RoodsBurger/brushless_lamp/MORNING_STATUS.md

> **HISTORICAL (C6 era, 2026-03) — superseded by s3/README.md. Do NOT follow the recommendations below; in particular item 4 (enable CHIP_SHELL) was later proven to TWDT-panic production boots (see s3/README §7.1).**

# Morning status — BrushlessLamp native ESP-IDF migration

**TL;DR:** Working native ESP-IDF + esp-matter firmware is built, flashed, and ready to commission. The upstream C6 `chip[DL]` WiFi-reconnect crash fix ([PR#42320](https://github.com/project-chip/connectedhomeip/pull/42320)) is cherry-picked and verified — no panic in 2 min of stable uncommissioned operation + multiple soft-resets. Only the actual Google-Home-commissioning + end-to-end motor tests need your physical presence.

## What's on the board right now

The C6 is flashed with `~/esp/brushlesslamp/esp-idf/build/brushlesslamp.bin`. It prints its QR + manual pairing code on boot and advertises BLE for commissioning. Build is using the default esp-matter test VID/PID so the QR is the same as any other default-config device:

- **QR:** `MT:Y.K9042C00KA0648G00`
- **QR URL:** `https://project-chip.github.io/connectedhomeip/qrcode.html?data=MT%3AY.K9042C00KA0648G00`
- **Manual pairing code:** `34970112332`

**This means the shared-QR collision issue with CylinderLamp is still present** (if you have CylinderLamp in the same fabric, remove it first). Per-device unique QR is documented as the next production milestone — see below.

## The tests you need to run in the morning

### Test 1: Commissioning first-try reliability (the central PR#42320 verification)

Attach the monitor and commission via Google Home:
```sh
source ~/esp/esp-idf/export.sh
source ~/esp/esp-matter/export.sh
cd ~/esp/brushlesslamp/esp-idf
idf.py -p /dev/cu.usbmodem101 monitor      # exit with Ctrl+]
```

Open Google Home → Add device → Matter-enabled → scan the QR URL above (or type the manual code). What you should see in the log:
```
I (XXX) chip[DL]: CHIPoBLE advertising started
... (controller connects via BLE) ...
... (SPAKE2+ exchange succeeds) ...
... (WiFi credentials applied) ...
I (XXX) chip[DL]: CommissioningComplete
I (XXX) blamp: event: CommissioningComplete — initializing motor + FOC
I (XXX) motor: driver.init() = 1
I (XXX) motor: motor.init() done
I (XXX) motor: motor.initFOC() = 1  zero_elec=X.XXXX  dir=1
I (XXX) motor: motor + FOC ready
I (XXX) blamp: event: BLEDeinitialized — free heap: YYYYYY
```
No `Guru Meditation`, no `MTVAL : 0x000000a8`, no `transport: 201`.

### Test 2: Post-commission reboot stability (**critical for reliability**)

This is the exact scenario the Arduino build crash-looped on. Power-cycle the C6 (unplug/replug USB), immediately attach monitor. Device should come back commissioned, WiFi reconnects, Google Home regains control within seconds. **No panic. No QR re-prints.** If this works, PR#42320 has paid for itself.

Repeat 5× to confirm.

### Test 3: Google Home command responsiveness

Once commissioned, from the Google Home app:
- Toggle ON/OFF → lamp responds within ~150 ms
- Drag brightness slider → motor moves smoothly
- Drag CT slider → WW/CW LED mix shifts

### Test 4: Bench-test path (knob + button)

With device commissioned (or not), verify hardware UX:
- Short-click knob → motor inits if uncommissioned; cycles knob mode (position/brightness) if already inited
- Turn knob in position mode → motor moves, Matter slider in Google Home follows
- Turn knob in brightness mode → LED dims (Matter doesn't know about LED brightness; it's local-only)
- Double-click → speed preset cycles (5 / 10 / 20 / 30 rad/s), pulses LEDs N+1 times for preset N
- Hold 5 s → smooth LED warning pulse animation
- Hold 9 s → factory reset (`esp_matter::factory_reset()` + reboot)

### Test 5: WiFi flap recovery

Pull router for 30 s, restore. Chip should:
- Notice disconnect (serial log shows `WIFI_EVENT_STA_DISCONNECTED`)
- Reconnect cleanly when router comes back (no panic)
- Resume Google Home control

## Everything that's done (phases 0-4)

### Phase 0 — Toolchain + patch
- ✅ ESP-IDF v5.4.4 installed at `~/esp/esp-idf/` (latest patch in v5.4 line; esp-matter's officially tested version for C6)
- ✅ esp-matter release/v1.5 at `~/esp/esp-matter/`
- ✅ connectedhomeip PR#42320 cherry-picked (4 files, `esp-idf/connectedhomeip-pr42320.patch`)
- ✅ esp-matter's `examples/light` built + flashed — boots clean, proves toolchain works

### Phase 1-4 — BrushlessLamp IDF project
- ✅ `esp-idf/` source tree in the git repo: `main/app_main.cpp`, `app_driver.cpp`, `motor.cpp`, `leds.cpp`, `input.cpp`, `persistence.cpp`, `pins.h`, `config.h`
- ✅ Build worktree at `~/esp/brushlesslamp/esp-idf/` (required — cmake doesn't handle spaces in project paths)
- ✅ esp_simplefoc v1.2.3 integrated, MCPWM backend on C6, 2 kHz GPTimer FOC ISR
- ✅ PCNT-decoded knob + polled button, full CylinderLamp-style state machine (short/double/long-press)
- ✅ Matter ColorTemperatureLight endpoint wired up with `color_temperature_light::create()`, inbound attribute callbacks dispatch to motor/LED
- ✅ Event-driven `syncMatter` push (knob → fabric) with `ScopedChipStackLock`
- ✅ `esp_matter::factory_reset()` for user-triggered reset
- ✅ Stall detection + auto-disable at idle
- ✅ Direction-reversal 4× decel on ramp for snappy knob-flip response
- ✅ Smooth gamma-curve LED pulse animation
- ✅ Flash clean boot verified: QR prints, BLE advertises, mDNS publishes, no panics over 2 min of monitoring

### Production prep (next milestone, partial)
- ✅ `esp-matter-mfg-tool` process documented at `esp-idf/production/README.md`
- ✅ Single per-device factory partition generated as proof-of-concept: `esp-idf/production/out/fff1_8001/<uuid>/...`
- ⚠️ **Factory-data-provider sdkconfig flags revealed `CHIP_ERROR_NO_SHARED_TRUSTED_ROOT` (201) at server init** when mfg-tool's default cert chain is used without DAC in `esp_secure_cert`. Flags currently commented out in `sdkconfig.defaults`. To wire per-device unique QR properly: re-generate factory partition with `--dac-in-secure-cert` + flash the secure-cert partition alongside, or use a full PAA chain. Documented but not fully working.

## Build + flash cheat sheet

Every shell:
```sh
source ~/esp/esp-idf/export.sh
source ~/esp/esp-matter/export.sh
```

Edit source files in `/Users/rodolfo/Documents/Personal Projects/BrushlessLamp/esp-idf/` then mirror to the build path:
```sh
rsync -a --delete --exclude=build --exclude=managed_components \
  --exclude=sdkconfig --exclude=sdkconfig.old --exclude=dependencies.lock \
  --exclude=production/out \
  "/Users/rodolfo/Documents/Personal Projects/BrushlessLamp/esp-idf/" \
  ~/esp/brushlesslamp/esp-idf/
```

Then build/flash/monitor from the build worktree:
```sh
cd ~/esp/brushlesslamp/esp-idf
IDF_CCACHE_ENABLE=1 idf.py build
idf.py -p /dev/cu.usbmodem101 flash monitor
```

First build = ~25 min, subsequent incremental = ~30 s.

## Outstanding items

1. **Verify Test 2 (post-commission reboot) works** — the whole point of the migration. If it doesn't, debug.
2. **Fix factory-data-provider `trusted root` error** — re-generate factory partition with `--dac-in-secure-cert` and flash the `esp_secure_cert` partition alongside.
3. **Trim more flash** — currently 3% partition free. Can drop `esp_matter_bridge` and other unused components from CMake REQUIRES if needed.
4. **Optional: enable `CONFIG_ENABLE_CHIP_SHELL=y`** to get the `matter esp` serial-console for runtime tuning (equivalent of the Arduino sketch's `G`/`T`/`A` commands).

## Commit policy

The `esp-idf/` tree has NOT been committed to the `c6` branch of your repo — per the test-before-commit rule, I want you to confirm Google Home commissioning works first. Once verified, from the source repo:

```sh
cd "/Users/rodolfo/Documents/Personal Projects/BrushlessLamp"

# Discard the now-obsolete Arduino round-3 safe-mode edits (superseded by IDF build):
git checkout arduino/BrushlessLamp/BrushlessLamp.ino README.md

# Commit the native IDF migration:
git add esp-idf/ MORNING_STATUS.md
git commit -m "Native ESP-IDF + esp-matter migration (phases 0-4) with PR#42320 fix"
```

Optional follow-up once you're confident the IDF build is reliable (a week of daily use):
```sh
git rm -r arduino/
git commit -m "Remove Arduino sketch; native IDF build is the new source of truth"
```

**You also have a worktree branch `c6-build` at `~/esp/brushlesslamp/` that I used for building.** It's safe to delete once you've committed the IDF tree back to `c6`:
```sh
git worktree remove ~/esp/brushlesslamp
git branch -D c6-build
```

## Final verified state as of this writing

```
I (413) blamp: boot — free heap: 297652
I (417) blamp: color_temperature_light endpoint id: 1
I (1054) chip[DIS]: Updating services using commissioning mode 1
I (1056) chip[DIS]: Advertise commission parameter vendorID=65521 productID=32768 discriminator=3840/15 cm=1 cp=0 jf=0
I (1060) blamp: uncommissioned — short-click the knob to bench-test the motor
I (1062) chip[SVR]: SetupQRCode: [MT:Y.K9042C00KA0648G00]
I (1063) chip[SVR]: Manual pairing code: [34970112332]
I (1065) blamp: app_main done — free heap: 188312
I (1066) chip[DL]: CHIPoBLE advertising started
```

No panic, no transport error, no `chip[DL]` crash over ≥2 min of operation and multiple soft-resets. Device is ready for your Google Home pairing test this morning.

## Files added

- `esp-idf/CMakeLists.txt`, `sdkconfig.defaults`, `sdkconfig.defaults.esp32c6`, `partitions.csv`, `.gitignore`, `README.md`
- `esp-idf/main/CMakeLists.txt`, `idf_component.yml`, `pins.h`, `config.h`
- `esp-idf/main/app_main.cpp`, `app_driver.{h,cpp}`
- `esp-idf/main/motor.{h,cpp}`, `leds.{h,cpp}`, `input.{h,cpp}`, `persistence.{h,cpp}`
- `esp-idf/connectedhomeip-pr42320.patch` — the upstream fix, re-appliable with `git apply`
- `esp-idf/production/README.md`, `.gitignore`
- `MORNING_STATUS.md` (this file)
