RoodsBurger/brushless_lamp/PCB/PCBWay-BOM.xlsx

Sheet: BOM
Item # | *Designator | *Qty | Manufacturer | *Mfg Part # | Description / Value | *Package/Footprint | Type | LCSC# | Your Instructions / Notes
1 | U_MCU | 1 | Espressif | ESP32-S3-WROOM-1-N8R8 | ESP32-S3-WROOM-1-N8R8 | Module | SMD | C2913201 | WiFi/BLE MCU module 8MB+8MB; 8MB N8R8 (C2913202 is the N16R8); LCSC verified
2 | U_DRV | 1 | Texas Instruments | DRV8313PWPR | DRV8313PWPR | HTSSOP-28 | SMD | C92482 | 3-phase BLDC gate driver; thermal pad to GND
3 | U_BUCK | 1 | Texas Instruments | LMR51430YDDCR | LMR51430YDDCR | SOT-23-6 | SMD | C5210749 | 24V->3.3V 3A buck
4 | D_USB | 1 | STMicroelectronics | USBLC6-2SC6 | USBLC6-2SC6 | SOT-23-6 | SMD | C7519 | USB ESD protection array
5 | Q_WW;Q_CW | 2 | Alpha & Omega | AO3400A | AO3400A | SOT-23 | SMD | C20917 | N-MOSFET LED low-side
6 | Q1 | 1 | Alpha & Omega | AO3401A | AO3401A | SOT-23 | SMD | C15127 | P-MOSFET reverse-protect
7 | D_OR_USB | 1 | MDD/Diodes | SS14 | SS14 | SMA | SMD | C2480 | Schottky 40V 1A; VBUS diode-OR to buck input
8 | D_Q1 | 1 | Shikues | BZT52C10 | BZT52C10 | SOD-123 | SMD | C216719 | Zener 10V 0.5W; Q1 gate-to-source clamp (AO3401A Vgs abs-max +/-12V)
9 | TVS1 | 1 | Littelfuse | SMBJ28A | SMBJ28A | SMB | SMD | C178227 | TVS 28V unidirectional 600W; 24V clamp - small/typical surges below buck 38V abs-max; full-surge VC 45.4V exceeds it (accepted residual risk)
10 | D_MCU | 1 | Bourns | CDSOD323-T03SC | ESD 3.3V | SOD-323 | SMD | C840638 | TVS/ESD 3.3V working; generic 3V3 ESD; optional - may DNP
11 | D_CLW;D_CLC | 2 | - | - | clamp | SOD-323 | DNS | - | LED drain TVS/Schottky; DNP - populate only if drain ringing >30V
12 | R_AZ_A;R_AZ_B;R_AZ_C | 3 | UNI-ROYAL | 0603WAF1002T5E | 10k | 0603 | DNS | C25804 | encoder A/B/Z pull-up stiffening to 3V3; DNP - populate only for a long/noisy encoder cable
13 | LED_STATUS | 1 | Everlight | 19-217/GHC-YR1S2/3T | Green LED | 0603 | SMD | C72043 | status indicator; generic green 0603; optional
14 | R_EN;R_BOOT;R_NSLEEP;R_NRESET;R_NFAULT;R_EN_DRV;R_FBB | 7 | UNI-ROYAL | 0603WAF1002T5E | 10k | 0603 | SMD | C25804 | thick-film 1%; pull-ups + buck FB bottom
15 | R_FBT | 1 | UNI-ROYAL | 0603WAF4532T5E | 45.3k | 0603 | SMD | C23058 | thick-film 1%; CRITICAL 1% - sets Vout=3.318V
16 | R_CC1;R_CC2 | 2 | UNI-ROYAL | 0603WAF5101T5E | 5.1k | 0603 | SMD | C23186 | USB-C CC pulldown 1%
17 | R_DP;R_DM | 2 | UNI-ROYAL | 0603WAF220JT5E | 22R | 0603 | SMD | C25092 | USB series
18 | R_Q1;R_ENB;R_PDW;R_PDC | 4 | UNI-ROYAL | 0603WAF1003T5E | 100k | 0603 | SMD | C25803 | thick-film; gate pulldowns + buck EN
19 | R_GW;R_GC | 2 | UNI-ROYAL | 0603WAF330JT5E | 33R | 0603 | SMD | C23140 | LED gate series; 33R 1%
20 | R_STATUS | 1 | UNI-ROYAL | 0603WAF1001T5E | 1k | 0603 | SMD | C21190 | LED series
21 | C_MCU3;C_MCU4;C_BOOT_B;C_SENS | 4 | Samsung | CL05B104KO5NNNC | 100nF | 0402 | SMD | C1525 | X7R 16V; decoupling
22 | C_BOOT | 1 | Samsung | CL05C101JB5NNNC | 100pF | 0402 | SMD | C26409 | C0G 50V; GPIO0 debounce - MUST stay small (never ~0.1uF); check stock
23 | C_FF | 1 | Samsung | CL05C220JB5NNNC | 22pF | 0402 | SMD | C70464 | C0G 50V; buck feed-forward (optional)
24 | C_MCU2;C_EN | 2 | Samsung | CL10B105KB8NNNC | 1uF | 0603 | SMD | C15849 | X7R 16V
25 | C_VBUS | 1 | Samsung | CL10A475KO8NNNC | 4.7uF | 0603 | SMD | C19666 | X5R 16V; VBUS bulk
26 | C_CP | 1 | Samsung | CL10B103KB8NNNC | 10nF | 0603 | SMD | C1589 | 50V X7R; charge-pump flying cap (VM-rated)
27 | C_VCP;C_VM1;C_VM2 | 3 | Samsung | CL10B104KB8NNNC | 100nF | 0603 | SMD | C1591 | 50V X7R; VCP + VM decoupling
28 | C_V3P3 | 1 | Samsung | CL10B474KO8NNNC | 470nF | 0603 | SMD | C105526 | 16V X7R; DRV V3P3 bypass (X7R; was X5R MPN not cataloged)
29 | C_MCU1 | 1 | Samsung | CL21A106KAYNNNE | 10uF | 0805 | SMD | C15850 | X5R 16V
30 | C_OUT1;C_OUT2 | 2 | Samsung | CL21A226KOQNNNE | 22uF | 0805 | SMD | C45783 | X5R 10V; buck output
31 | C_IN1 | 1 | Samsung | CL32B106KBJNNNE | 10uF | 1210 | SMD | C46653 | 50V X7R; buck input (derated 50V)
32 | C_IN2 | 1 | Samsung | CL31B475KBHNNNE | 4.7uF | 1206 | SMD | C51205 | 50V X7R; buck input (BH=50V; CH MPN was a typo)
33 | C_MCU_BULK | 1 | Kemet | T520D477M006ATE025 | 470uF 6.3V | 7343 (D) | SMD | C156460 | polymer/tantalum-polymer; *confirm CAP_D land; cures TX brownout; LCSC stock thin-buy ahead or alt T520D477M006ATE030
34 | C_IN_BULK;C_VM_BULK | 2 | Panasonic | EEE-FK1H101P | 100uF 50V | 8x10.5mm | SMD | C178548 | aluminium electrolytic SMD; *confirm CAP_V land (D8x10.2mm can)
35 | L1 | 1 | Sunlord | SWPA4030S4R7MT | 4.7uH | 4x4mm | SMD | C57269 | shielded power inductor >=1.5A; *confirm IND43 land; Wurth 74438335047 alt is 3x3mm (not land-compatible)
36 | SW_RST;SW_BOOT | 2 | XKB/various | TS-1187A-B-A-B | tactile | SMD | SMD | C318884 | SMD pushbutton 4-pad; XKB TS-1187A-B-A-B land pattern, datasheet-verified; internal contacts bridge pads pairwise per side
37 | F1 | 1 | Littelfuse | 0454002.MR | 2A | NANO2 6.1x2.7mm | SMD | C179005 | slow-blow NANO2 fuse; slo-blo; 125V rating satisfies >=63VDC need; verify FUSE_NANO2 land before fab
38 | J_USB | 1 | HRO | TYPE-C-31-M-12 | USB-C 16P | SMT | SMD | C165948 | USB-C receptacle; shell legs require PLATED SLOTS: 4x 0.6x1.7mm. Drill file represents each slot as overlapping 0.6mm drills - cut as slots per the Milling layer, do NOT drill as round holes (previous order T-1P9W1088173A failed on this).
39 | J_BTN | 1 | JST | B2B-XH-A | JST-XH 2P | THT 2.5mm | THT | C144395 | header (mate XHP-2); button SW/GND
40 | J_KNOB;J_LED | 2 | JST | B3B-XH-A | JST-XH 3P | THT 2.5mm | THT | C158012 | header (mate XHP-3); knob A/B/GND and LED V+/W/C
41 | J_PWR | 1 | Cixi Kefa | KF301-5.0-2P | Screw 2P 5.0mm | THT | THT | C474881 | terminal block; 24V V+/V-
42 | J_MOTOR | 1 | Cixi Kefa | KF301-5.0-3P | Screw 3P 5.0mm | THT | THT | C474882 | terminal block; motor U/V/W
43 | J_SENSOR-A | 1 | Cixi Kefa | KF350-3.5-3P | Screw 3P 3.5mm | THT | THT | C474893 | terminal block; encoder VCC/GND/A - 3P half; gangs with J_SENSOR-B onto the 5-pos 3.5mm SCREW5 footprint (no 5P block stocked on LCSC). Both BOM lines mount at CPL designator J_SENSOR.
44 | J_SENSOR-B | 1 | Cixi Kefa | KF350-3.5-2P | Screw 2P 3.5mm | THT | THT | C474892 | terminal block; encoder B/Z - 2P half; butts against J_SENSOR-A to fill the 5-pos block. Mounts at CPL designator J_SENSOR (see J_SENSOR-A).
45 | J_EXP | 1 | BOOMELE | 2.54-1*10P | GPIO header 1x10 | THT 2.54mm | THT | C57369 | 2.54mm male pin header; spare IO1/IO2/IO13/IO38-42 + 3V3/GND; DNP if you prefer bare pads
46 | J_PROG | 1 | - | - | prog pads | SMD pads | DNS | - | UART fallback pad field; DNP - bare test pads

Sheet: Order Notes
PCBWay order remarks (paste into the order notes field):
1 | USB-C (J_USB) shell legs are PLATED SLOTS: 4x 0.6x1.7mm. The drill file shows them as overlapping 0.6mm drills; follow the slots / Milling layer, do not drill round holes.
2 | BOM lines J_SENSOR-A (KF350-3.5-3P) and J_SENSOR-B (KF350-3.5-2P) are gangable halves that together populate the single 5-position footprint at CPL designator J_SENSOR.
3 | DNS lines (D_CLW, D_CLC, R_AZ_A/B/C, J_PROG) are do-not-populate.
4 | Board is 55x55mm, 4-layer; inner planes L2=GND, L15=3V3.
