RoodsBurger/brushless_lamp/PCB/components/KF350-2p.step

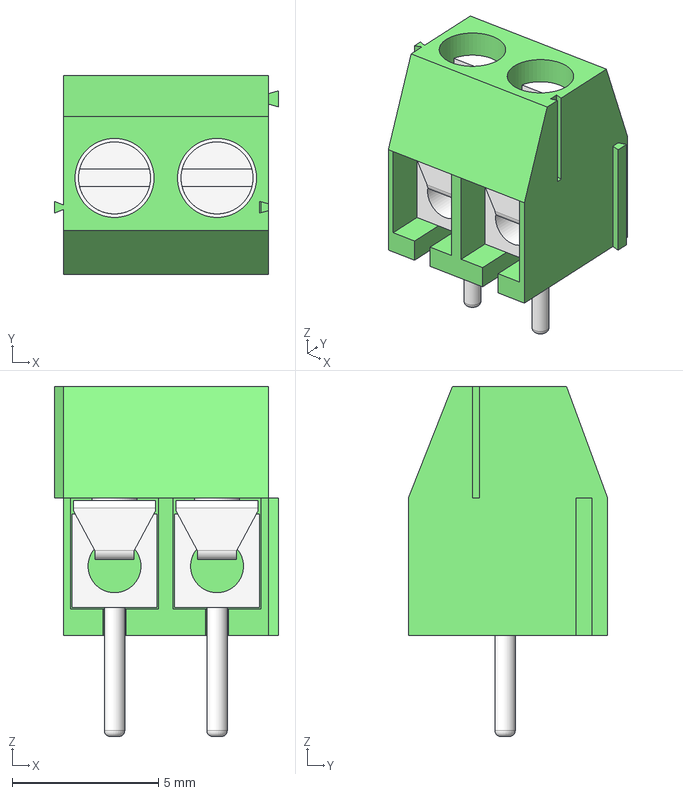
[picture p1: CAD file, 2026-07-13]
PCB/components/KF350-2p.step
7.65 x 6.80 x 11.9 mm
Corps
Conn_1
Conn_2
blade_1
blade_2
Vis_1
Vis_001
