RoodsBurger/brushless_lamp/PCB/components/TYPE-C-31-M-12--3DModel-STEP-56544.STEP

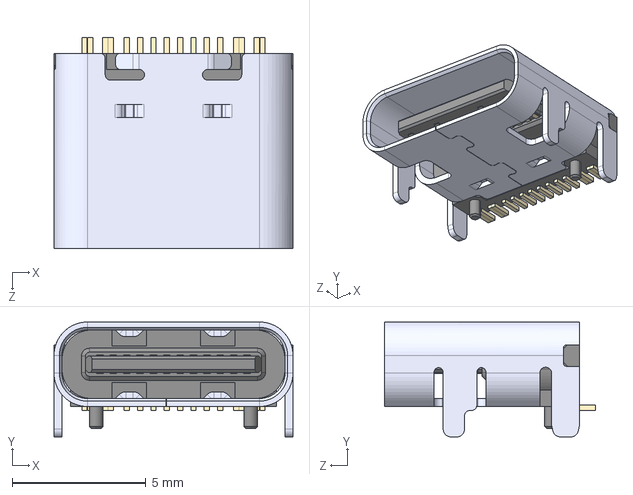
[picture p2: CAD file, 2026-07-13]
PCB/components/TYPE-C-31-M-12--3DModel-STEP-56544.STEP
8.94 x 4.30 x 7.90 mm
