RoodsBurger/brushless_lamp/PCB/components/TS-1187A-B-A-B--3DModel-STEP-56544.STEP

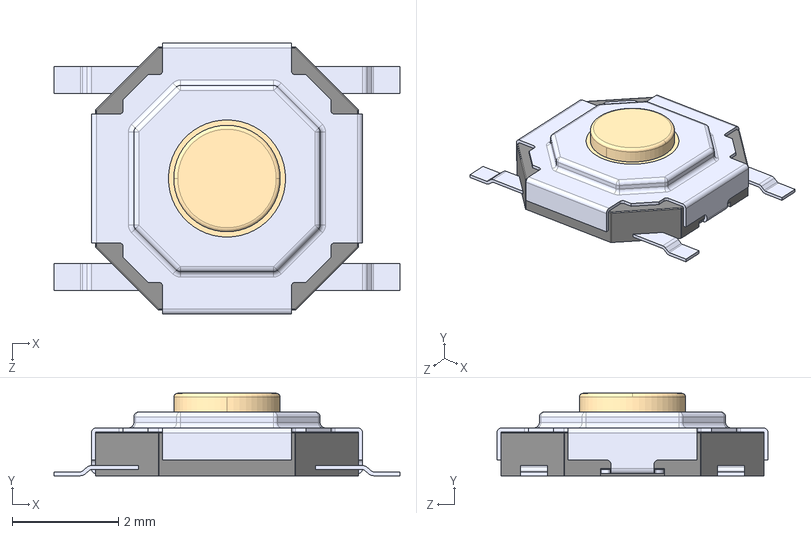
[picture p3: CAD file, 2026-07-13]
PCB/components/TS-1187A-B-A-B--3DModel-STEP-56544.STEP
6.50 x 1.55 x 5.10 mm
