RoodsBurger/brushless_lamp/PCB/components/KF350-3p.step

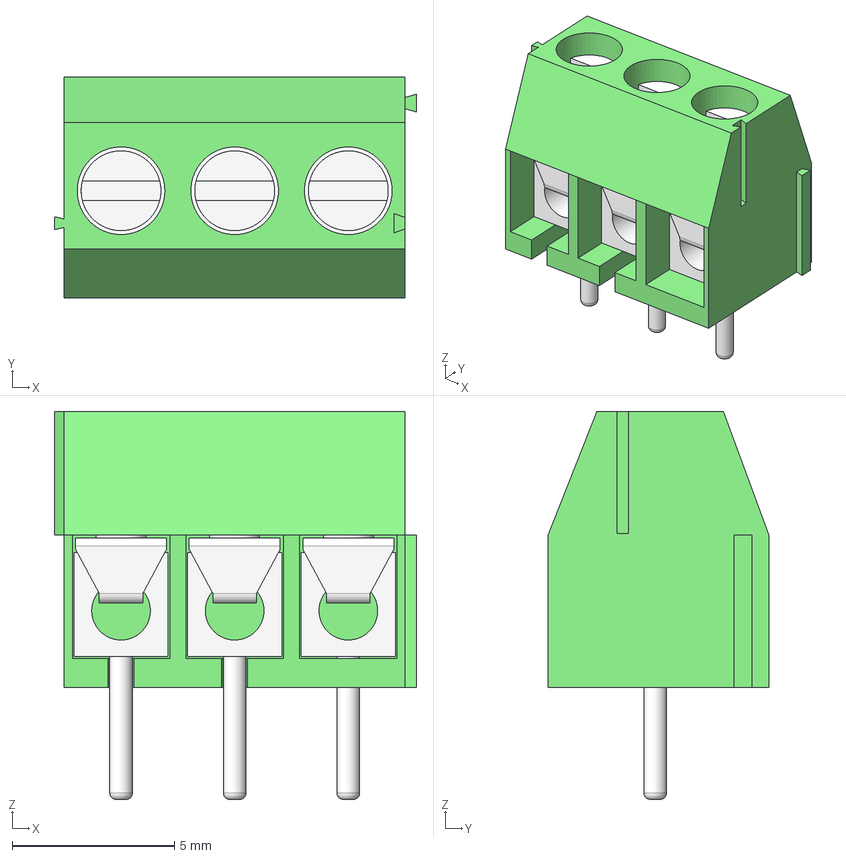
[picture p4: CAD file, 2026-07-13]
PCB/components/KF350-3p.step
11.2 x 6.80 x 11.9 mm
Corps
Conn_1 x 2
Conn_2
blade_1
blade_2 x 2
Vis_1 x 3
