RoodsBurger/brushless_lamp/PCB/components/B2B-XH-A--3DModel-STEP-56544.STEP

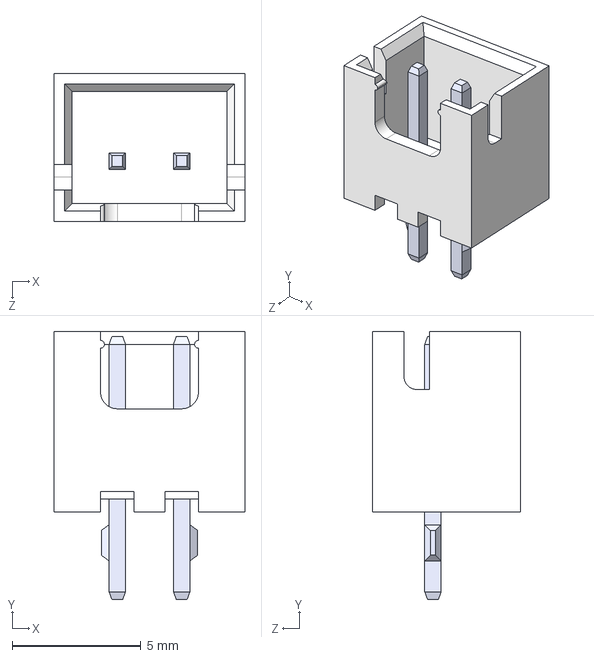
[picture p5: CAD file, 2026-07-13]
PCB/components/B2B-XH-A--3DModel-STEP-56544.STEP
7.40 x 10.4 x 5.75 mm
