RoodsBurger/brushless_lamp/PCB/components/B3B-XH-A--3DModel-STEP-56544.STEP

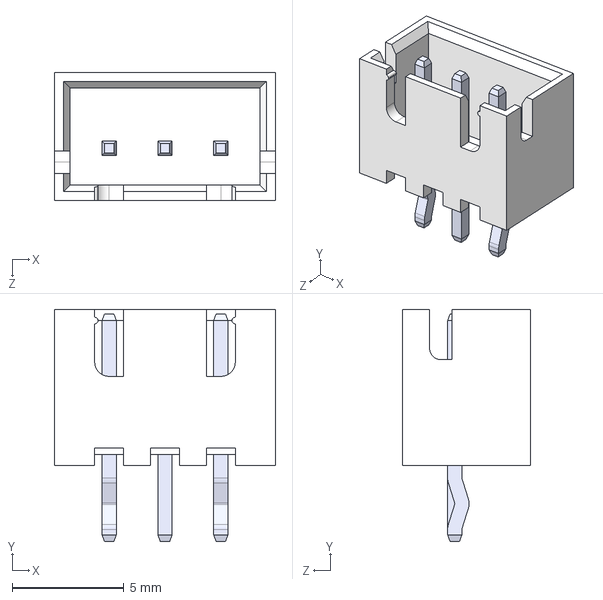
[picture p6: CAD file, 2026-07-13]
PCB/components/B3B-XH-A--3DModel-STEP-56544.STEP
9.90 x 10.4 x 5.75 mm
