RoodsBurger/brushless_lamp/PCB/components/DRV8313PWPR.STEP

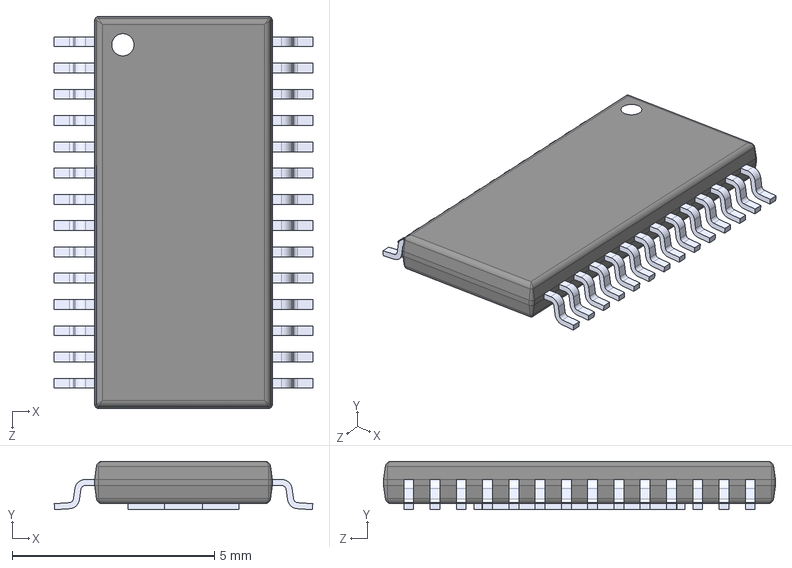
[picture p7: CAD file, 2026-07-13]
PCB/components/DRV8313PWPR.STEP
6.40 x 1.20 x 9.70 mm
