RoodsBurger/brushless_lamp/PCB/components/ESP32-S3-WROOM-1-N8R8.STEP

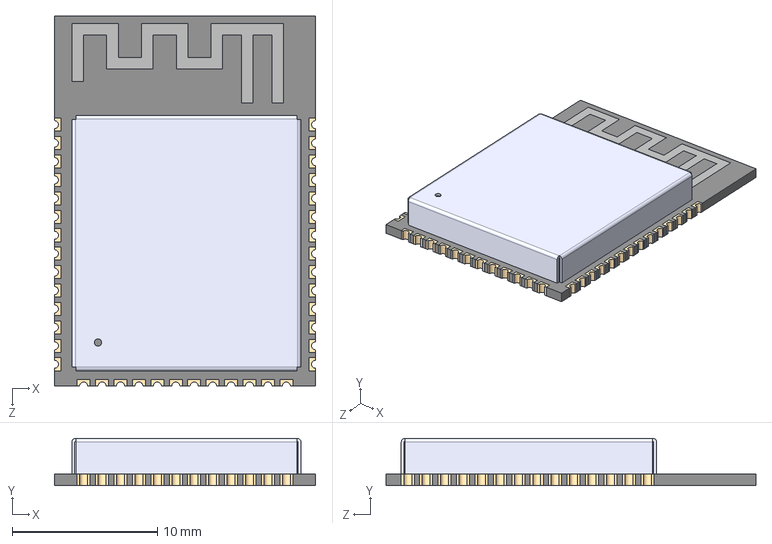
[picture p8: CAD file, 2026-06-08]
PCB/components/ESP32-S3-WROOM-1-N8R8.STEP
18.0 x 3.25 x 25.5 mm
