RoodsBurger/brushless_lamp/PCB/fusion/BrushlessLamp.brd

## EAGLE design PCB/fusion/BrushlessLamp.brd (2026-07-13)

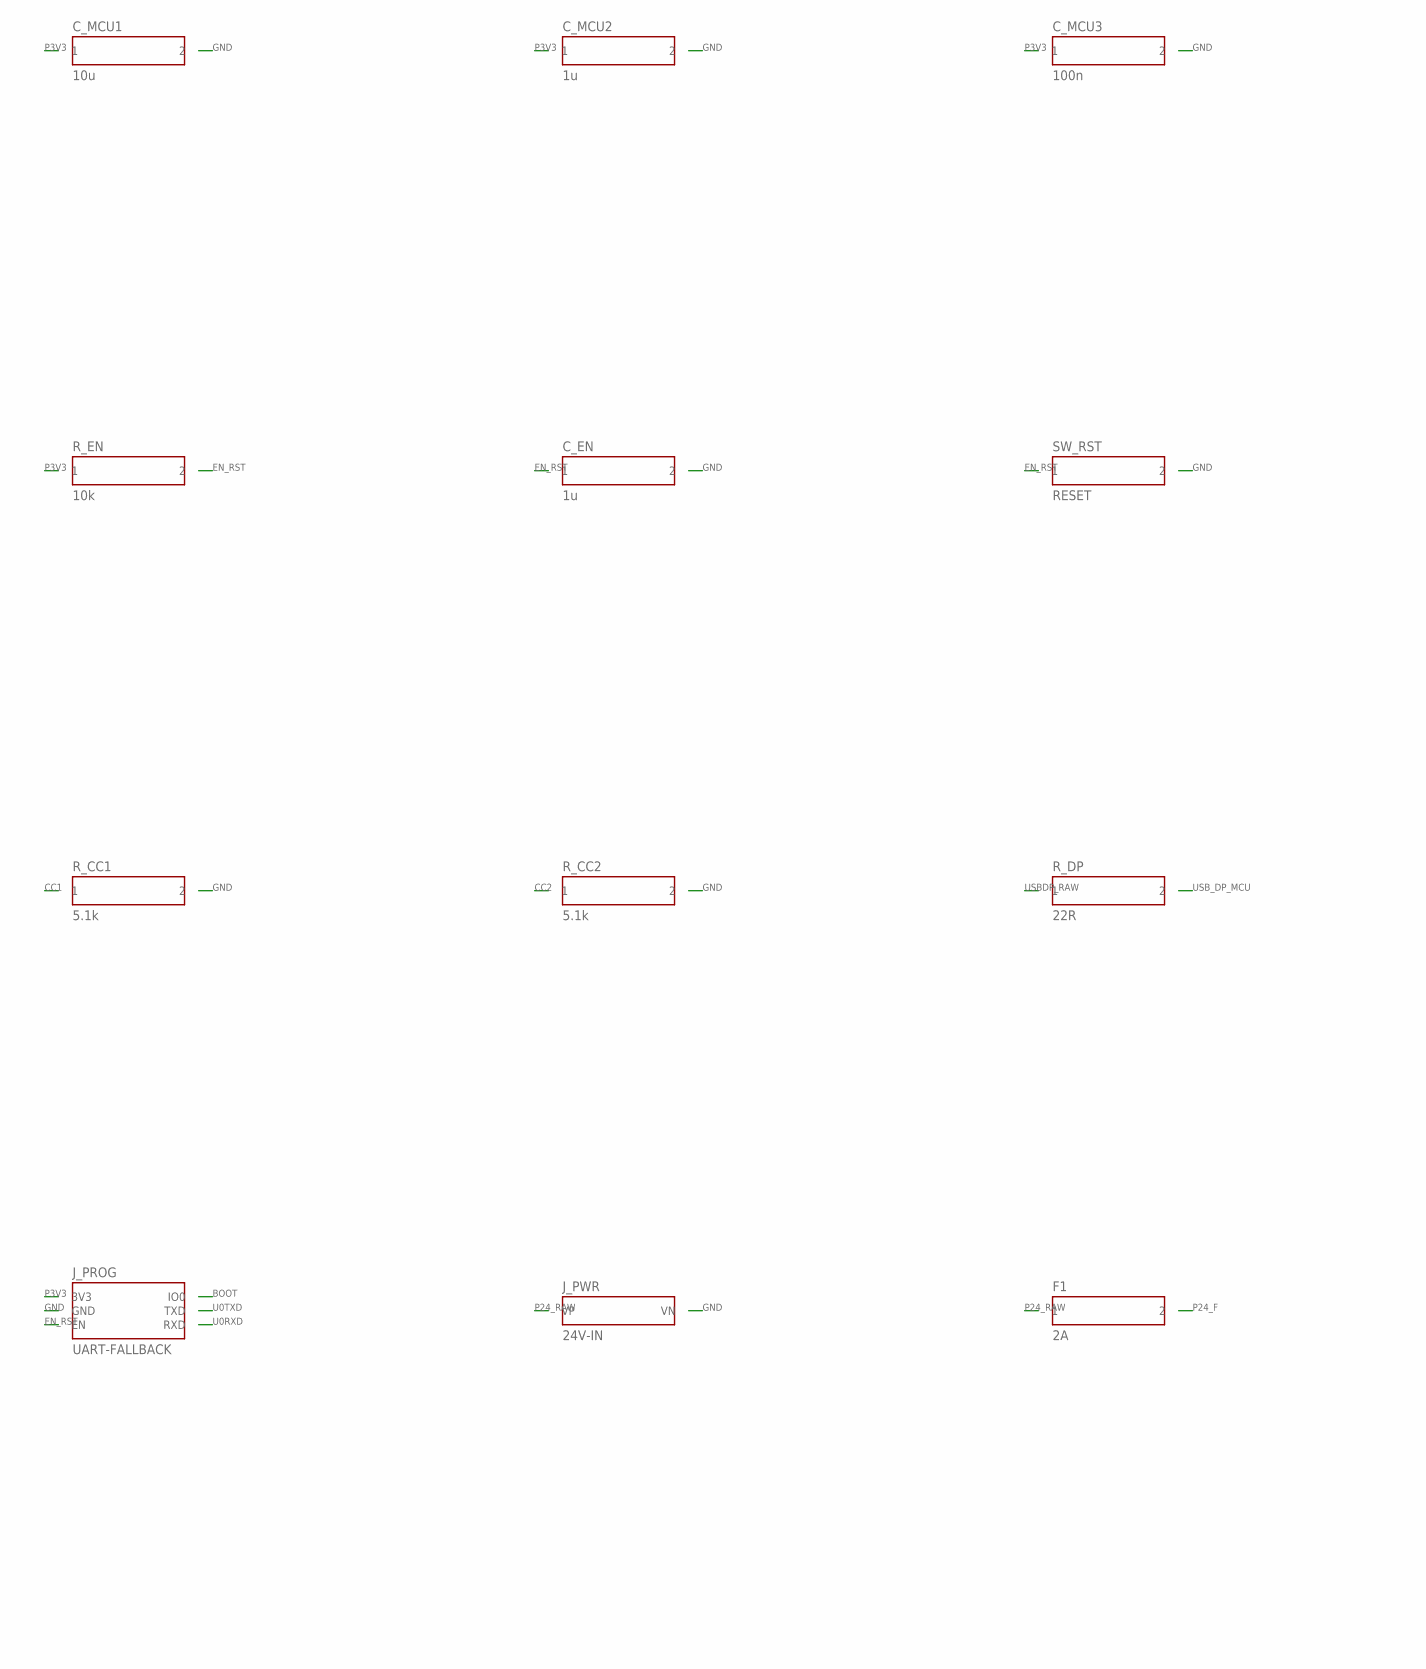
[picture p9: schematic BrushlessLamp.sch, part in row 1, column 1]

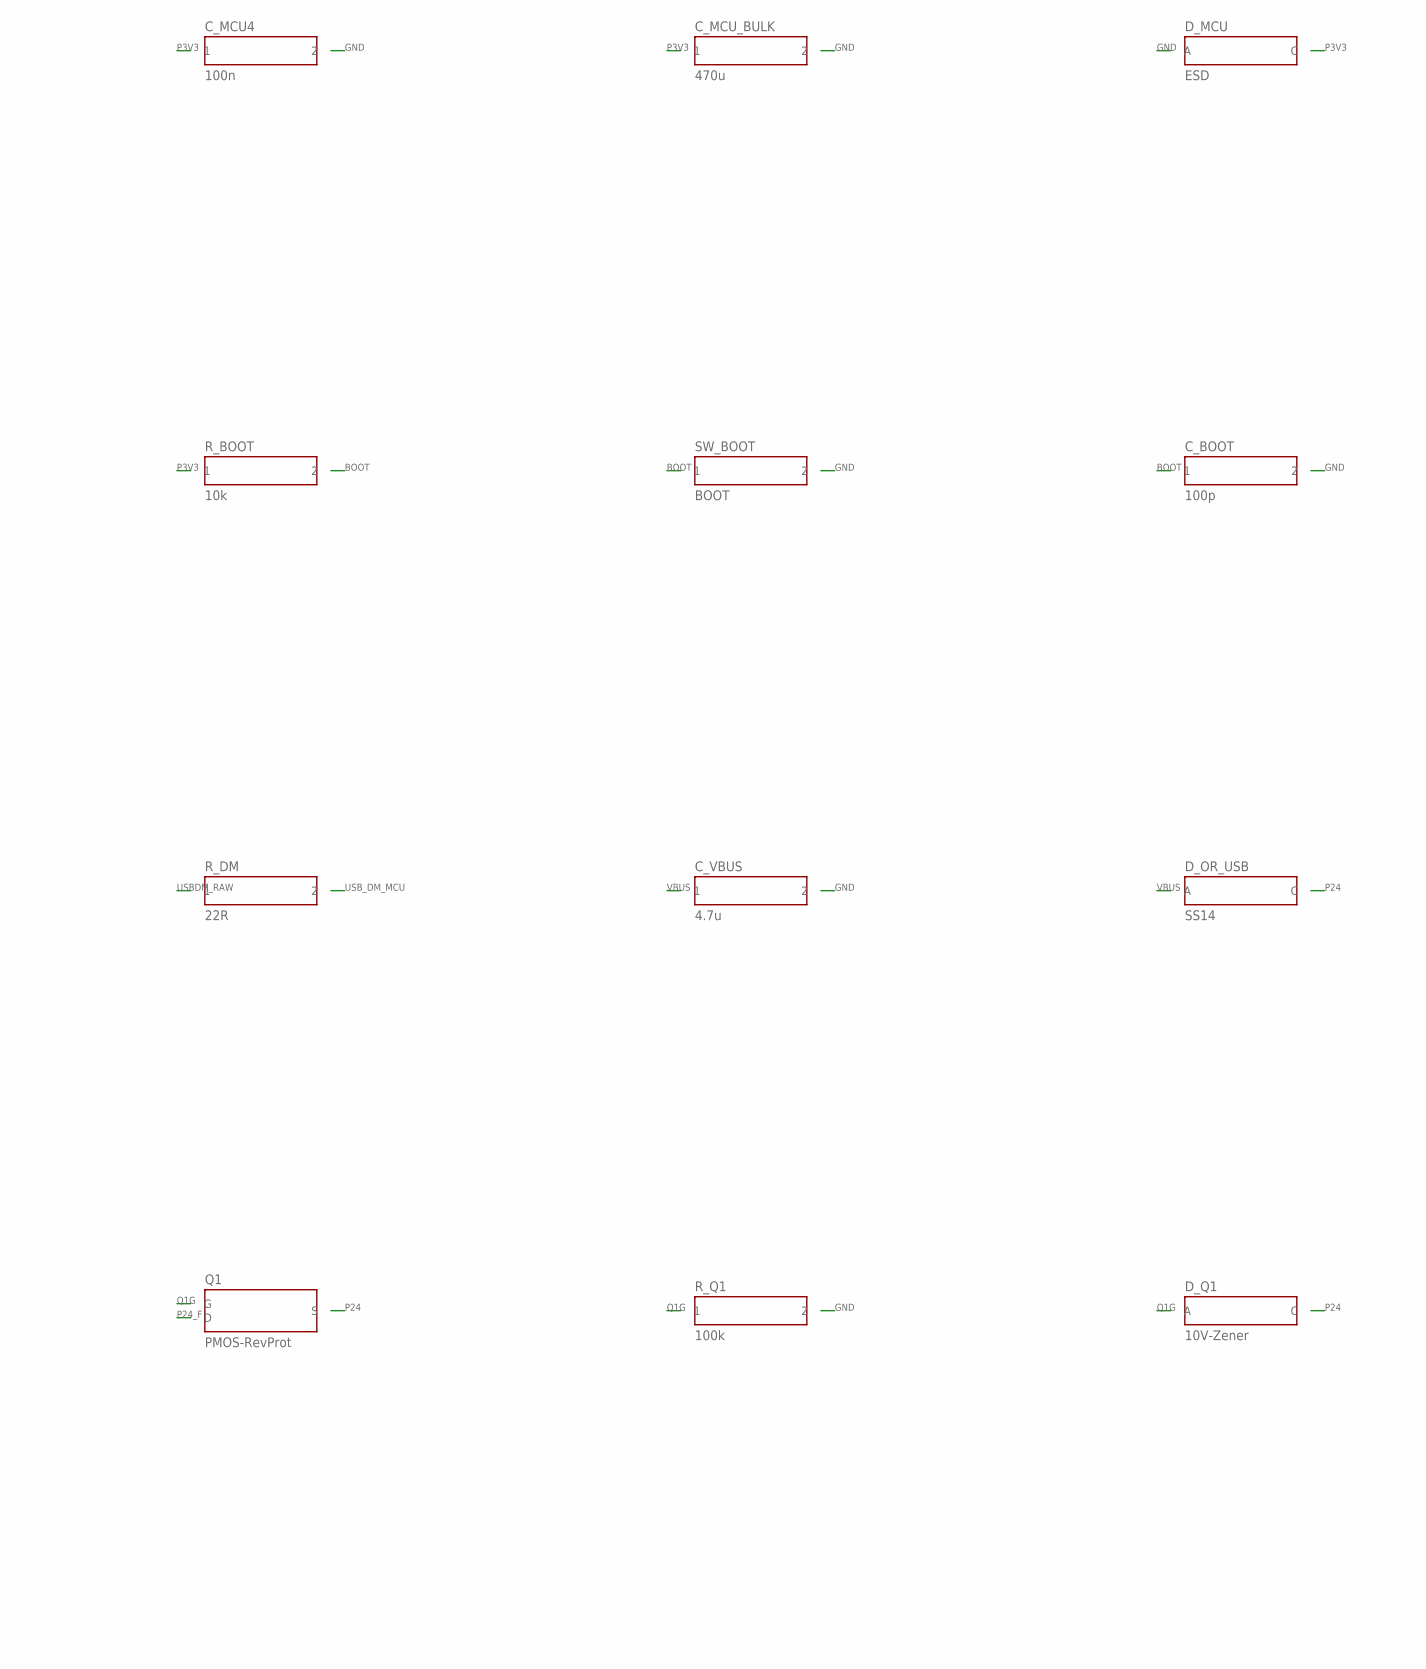
[picture p10: schematic BrushlessLamp.sch, part in row 1, column 2]

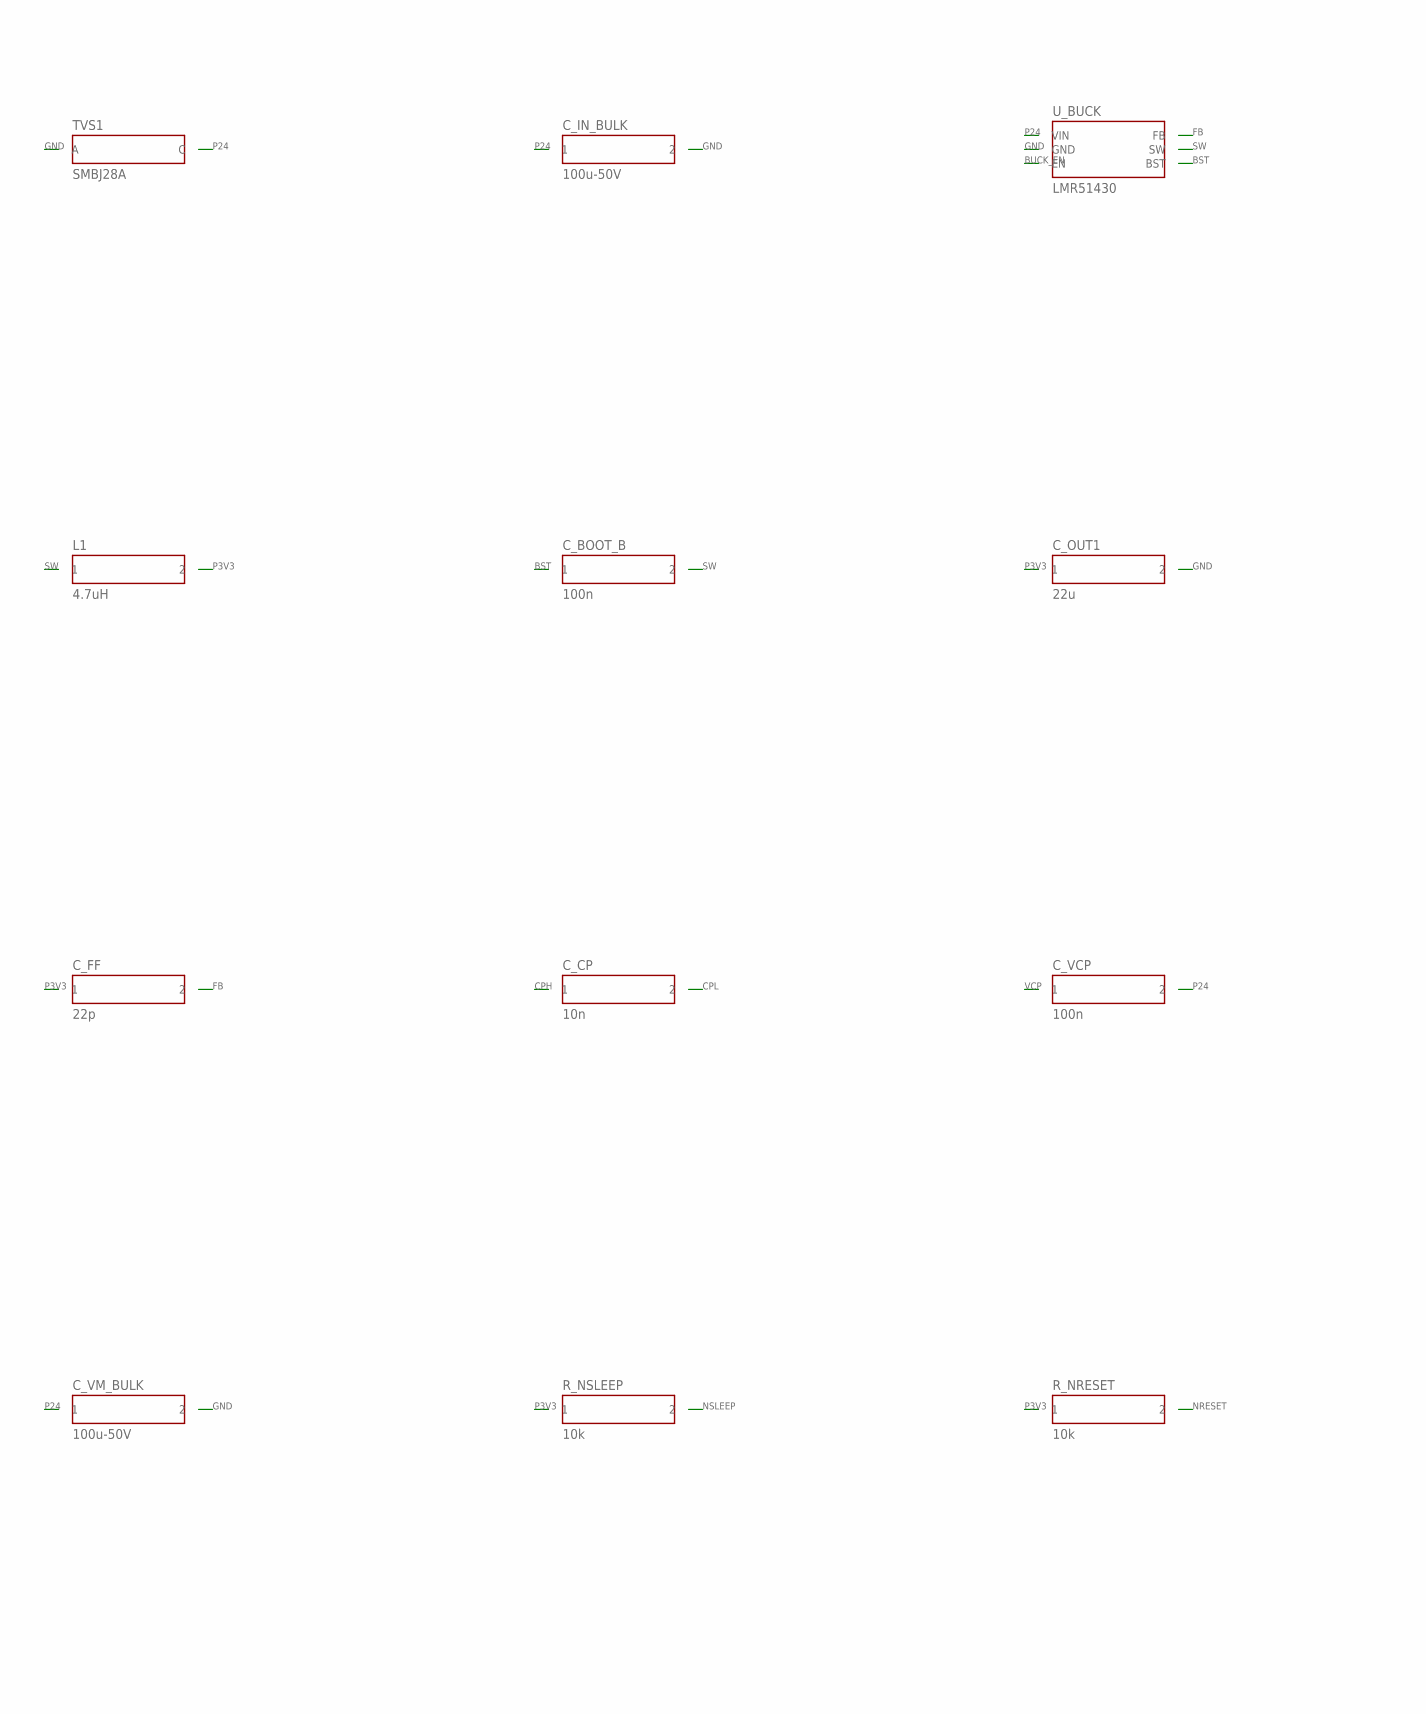
[picture p11: schematic BrushlessLamp.sch, part in row 2, column 1]

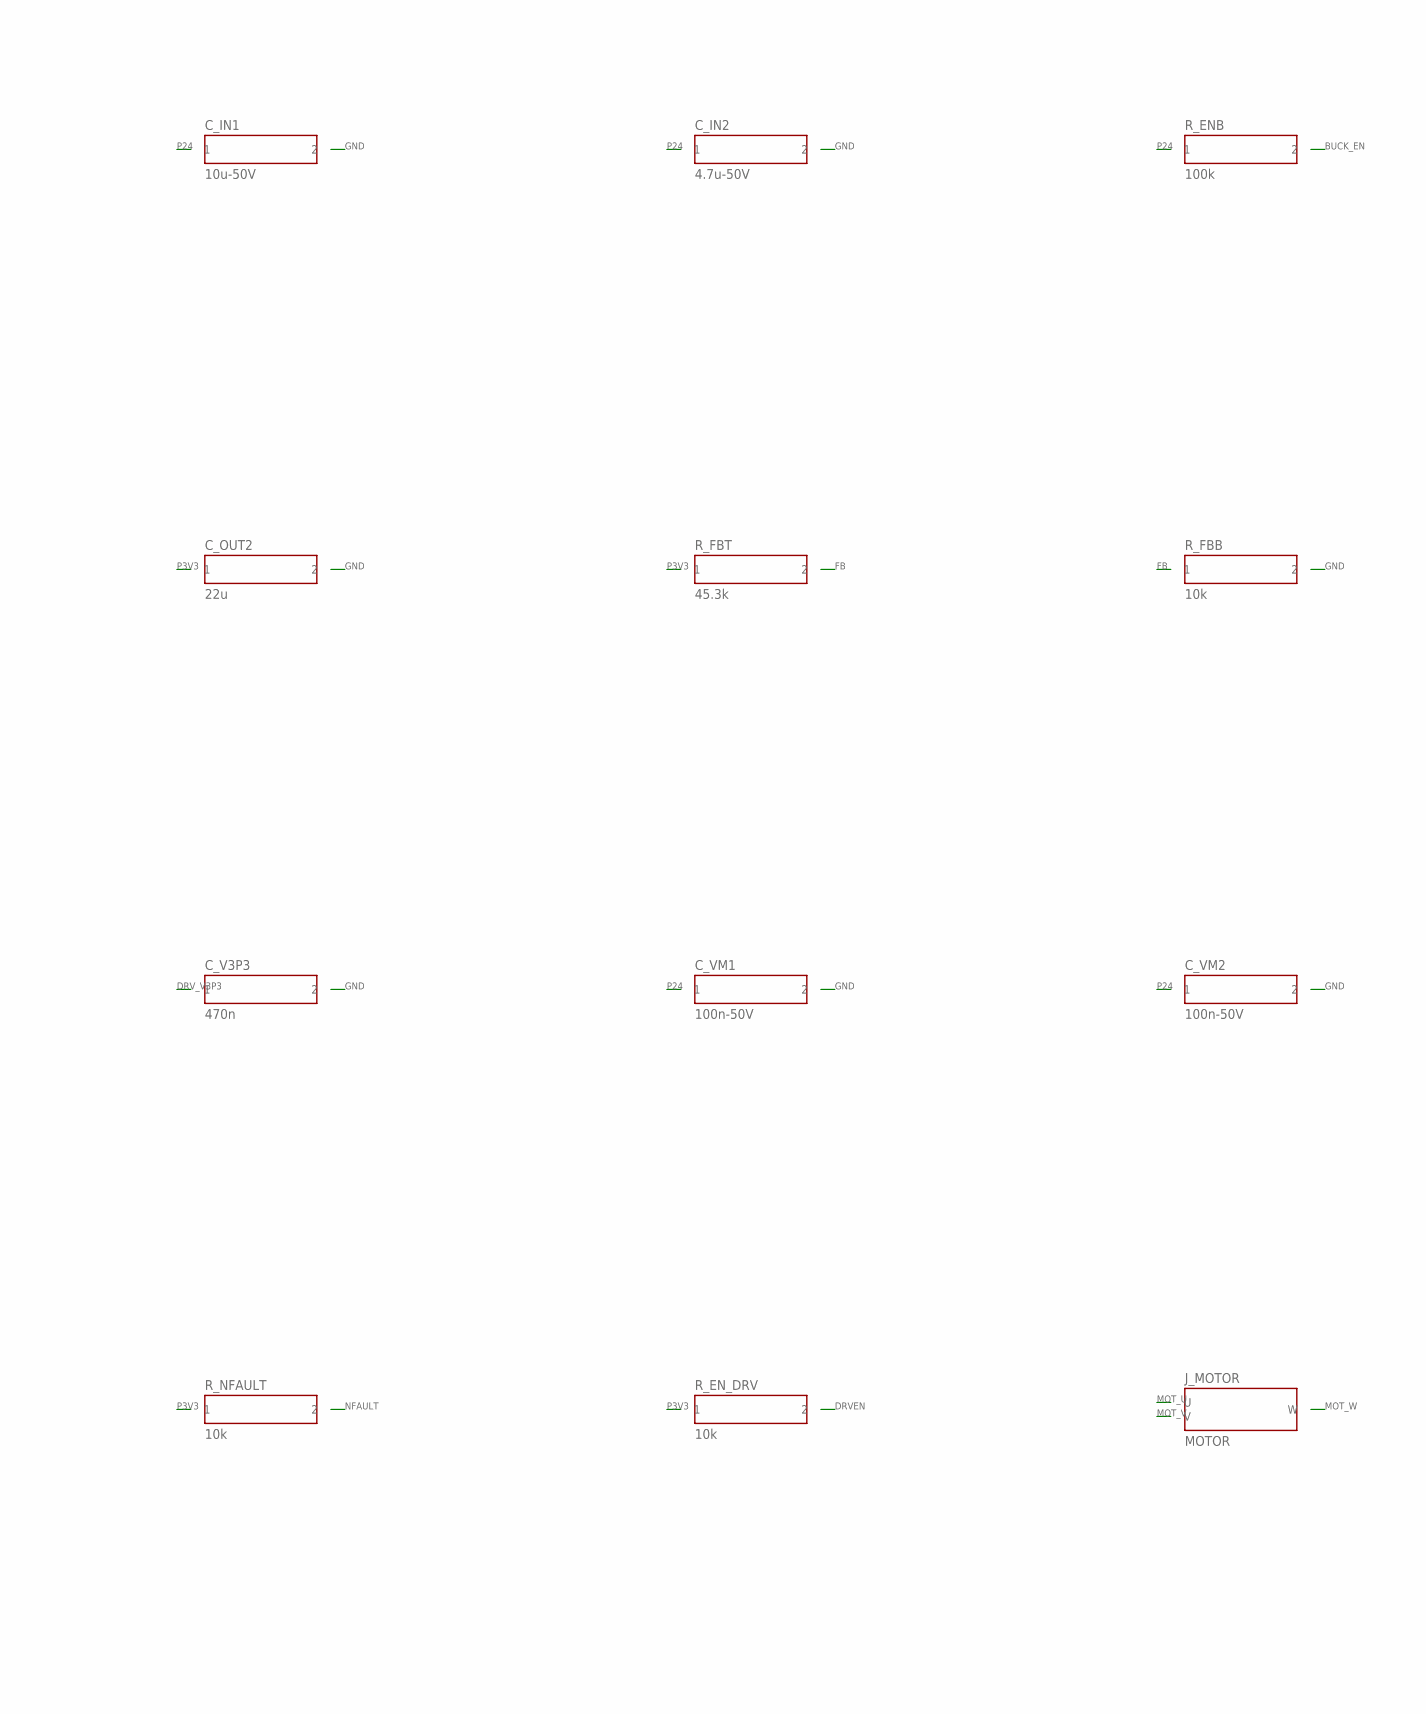
[picture p12: schematic BrushlessLamp.sch, part in row 2, column 2]

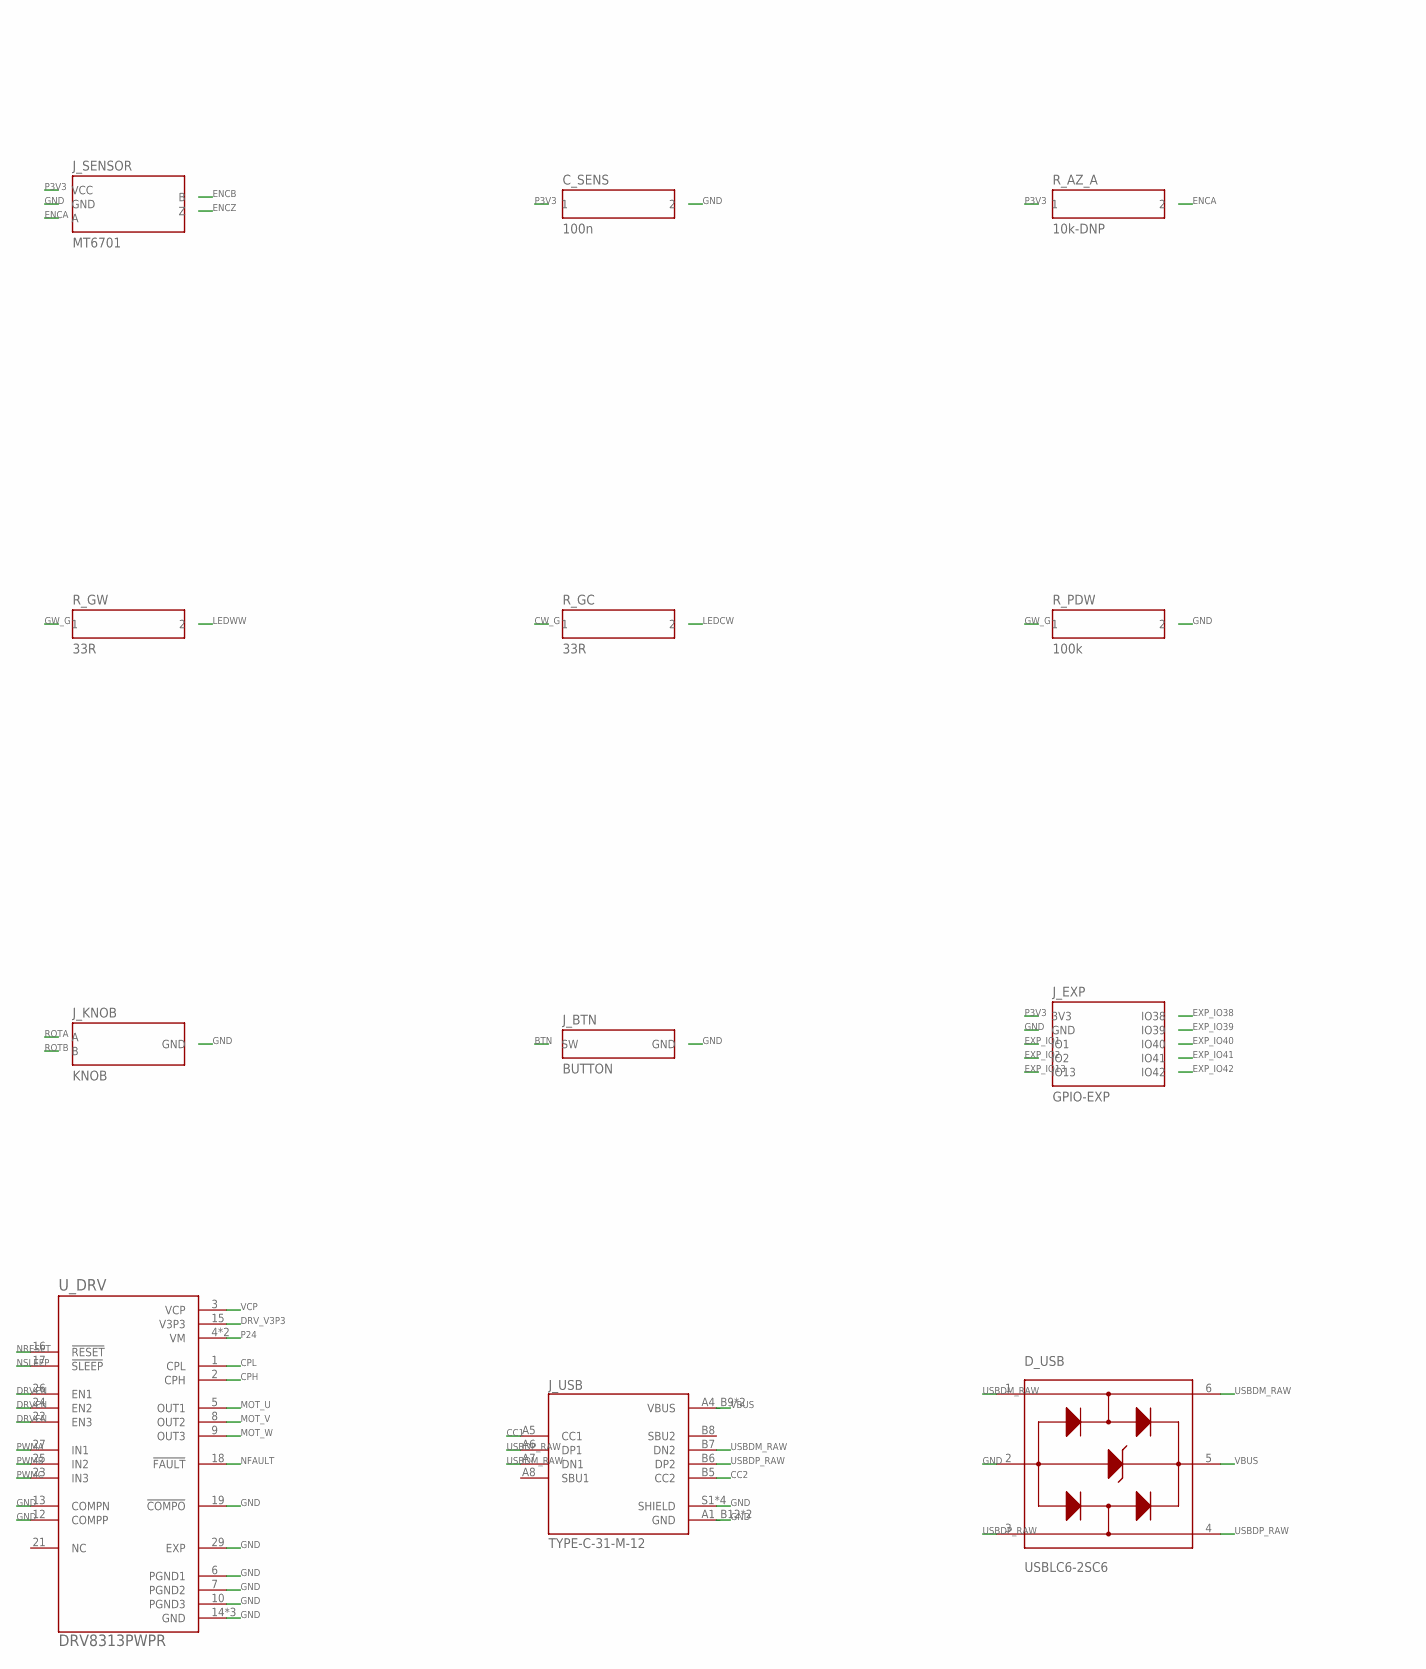
[picture p13: schematic BrushlessLamp.sch, part in row 3, column 1]

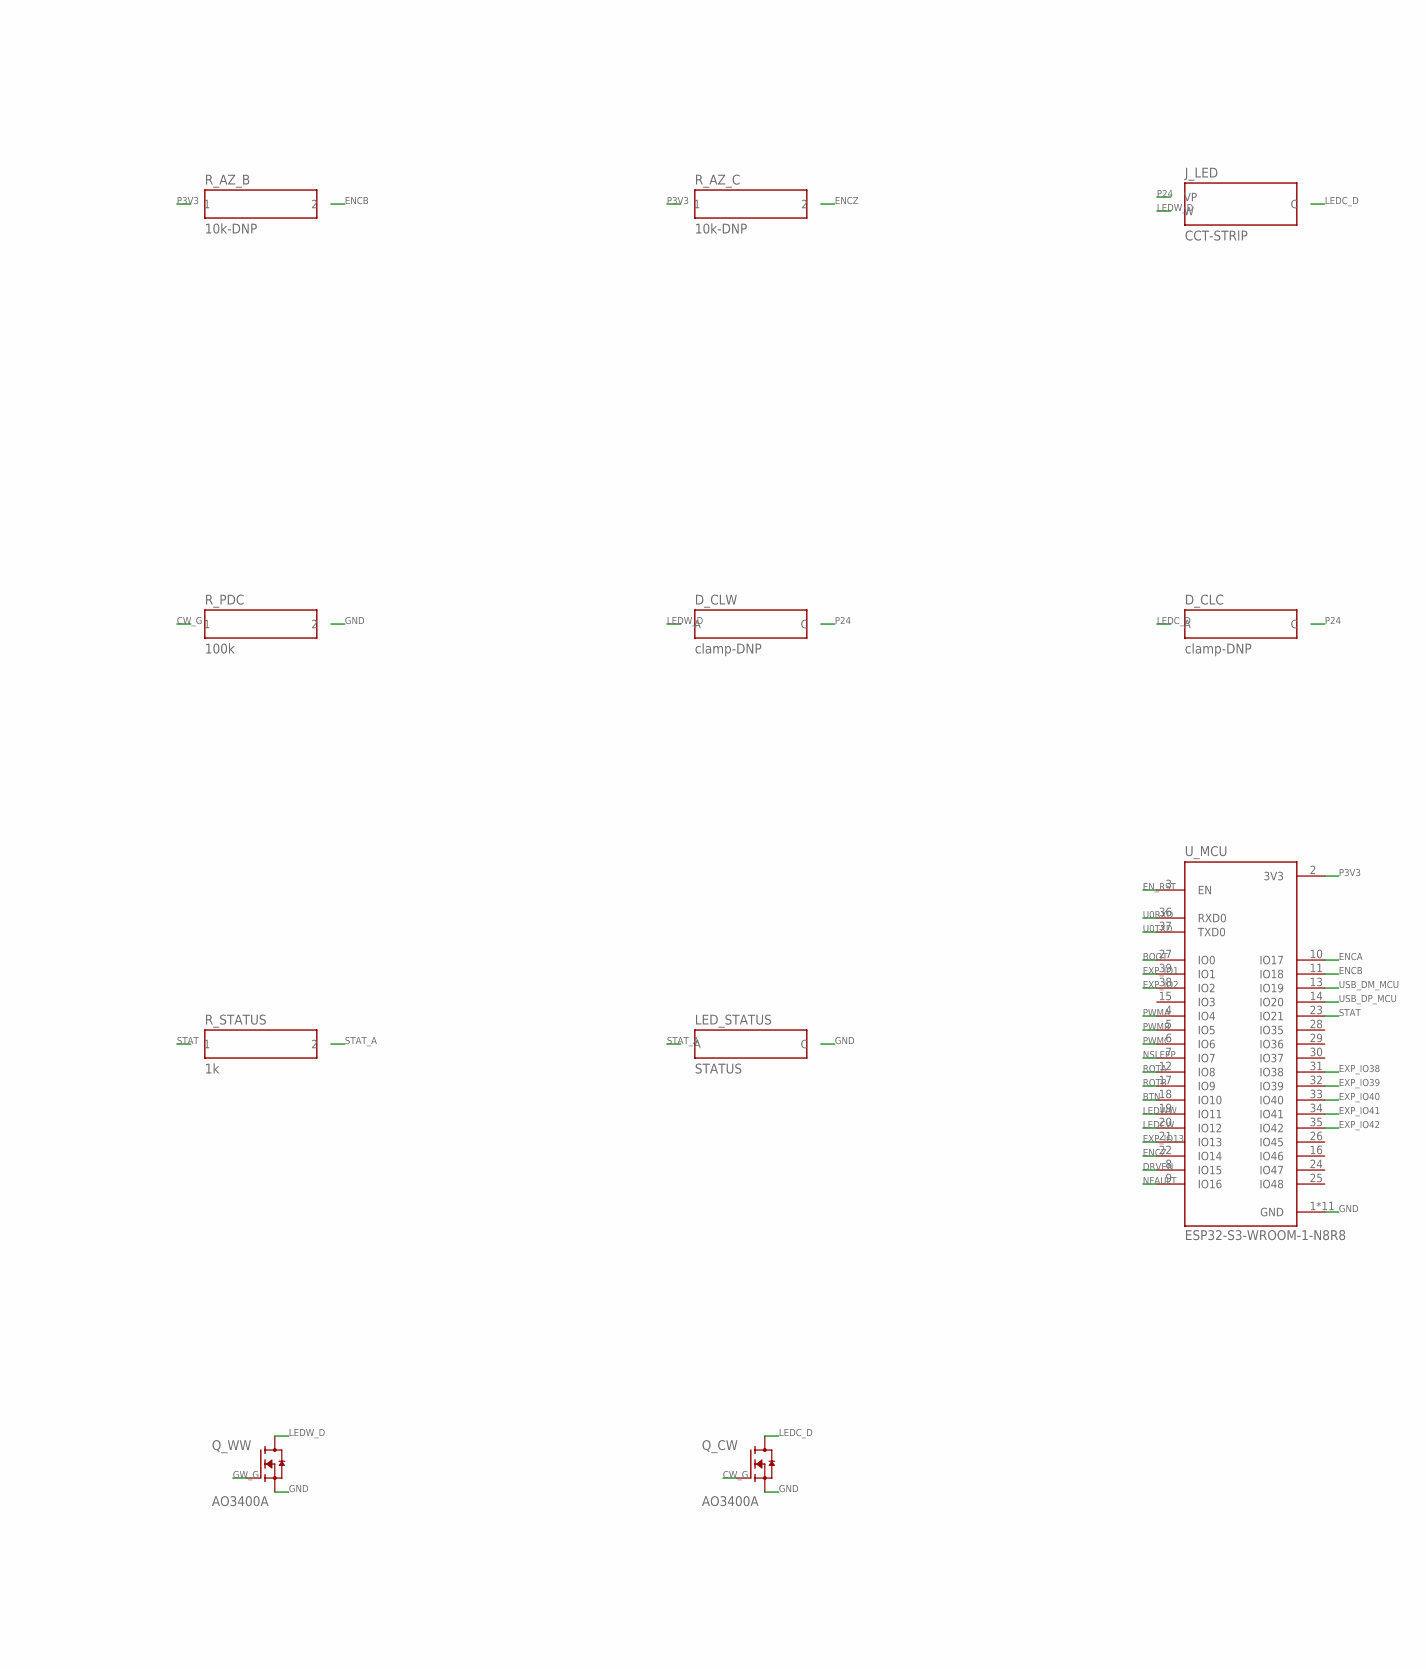
[picture p14: schematic BrushlessLamp.sch, part in row 3, column 2]

Parts:
C_BOOT: 100p; 0402
C_BOOT_B: 100n; 0402
C_CP: 10n; 0603
C_EN: 1u; 0603
C_FF: 22p; 0402
C_IN1: 10u-50V; 1210
C_IN2: 4.7u-50V; 1206
C_IN_BULK: 100u-50V; CAP_V
C_MCU1: 10u; 0805
C_MCU2: 1u; 0603
C_MCU3, C_MCU4: 100n; 0402
C_MCU_BULK: 470u; CAP_D
C_OUT1, C_OUT2: 22u; 0805
C_SENS: 100n; 0402
C_V3P3: 470n; 0603
C_VBUS: 4.7u; 0603
C_VCP: 100n; 0603
C_VM1, C_VM2: 100n-50V; 0603
C_VM_BULK: 100u-50V; CAP_V
D_CLC: clamp-DNP; SOD323
D_CLW: clamp-DNP; SOD323
D_MCU: ESD; SOD323
D_OR_USB: SS14; SMA
D_Q1: 10V-Zener; SOD123
D_USB: USBLC6-2SC6; SOT95P280X145-6N
F1: 2A; FUSENANO2
J_BTN: BUTTON; XH2
J_EXP: GPIO-EXP; HDR10
J_KNOB: KNOB; XH3
J_LED: CCT-STRIP; XH3
J_MOTOR: MOTOR; SCREW3
J_PROG: UART-FALLBACK; HDR6
J_PWR: 24V-IN; SCREW2
J_SENSOR: MT6701; SCREW5
J_USB: TYPE-C-31-M-12; HRO_TYPE-C-31-M-12
L1: 4.7uH; IND43
LED_STATUS: STATUS; LED0603
Q1: PMOS-RevProt; SOT23
Q_CW: AO3400A; SOT95P280X125-3N
Q_WW: AO3400A; SOT95P280X125-3N
R_AZ_A: 10k-DNP; 0603
R_AZ_B: 10k-DNP; 0603
R_AZ_C: 10k-DNP; 0603
R_BOOT: 10k; 0603
R_CC1, R_CC2: 5.1k; 0603
R_DM: 22R; 0603
R_DP: 22R; 0603
R_EN: 10k; 0603
R_ENB: 100k; 0603
R_EN_DRV: 10k; 0603
R_FBB: 10k; 0603
R_FBT: 45.3k; 0603
R_GC: 33R; 0603
R_GW: 33R; 0603
R_NFAULT: 10k; 0603
R_NRESET: 10k; 0603
R_NSLEEP: 10k; 0603
R_PDC: 100k; 0603
R_PDW: 100k; 0603
R_Q1: 100k; 0603
R_STATUS: 1k; 0603
SW_BOOT: BOOT; TACT
SW_RST: RESET; TACT
TVS1: SMBJ28A; SMB
U_BUCK: LMR51430; SOT236
U_DRV: DRV8313PWPR; SOP65P640X120-29N
U_MCU: ESP32-S3-WROOM-1-N8R8; XCVR_ESP32S3WROOM1N8R8

Connections:
BST: C_BOOT_B.1, U_BUCK.6 (BST)
BTN: J_BTN.1 (SW), U_MCU.18 (IO10)
BUCK_EN: R_ENB.2, U_BUCK.5 (EN)
CC1: J_USB.A5 (CC1), R_CC1.1
CC2: J_USB.B5 (CC2), R_CC2.1
CPH: C_CP.1, U_DRV.2 (CPH)
CPL: C_CP.2, U_DRV.1 (CPL)
CW_G: Q_CW.1 (G), R_GC.1, R_PDC.1
DRVEN: R_EN_DRV.2, U_DRV.22 (EN3), U_DRV.24 (EN2), U_DRV.26 (EN1), U_MCU.8 (IO15)
DRV_V3P3: C_V3P3.1, U_DRV.15 (V3P3)
ENCA: J_SENSOR.3 (A), R_AZ_A.2, U_MCU.10 (IO17)
ENCB: J_SENSOR.4 (B), R_AZ_B.2, U_MCU.11 (IO18)
ENCZ: J_SENSOR.5 (Z), R_AZ_C.2, U_MCU.22 (IO14)
EXP_IO1: J_EXP.3 (IO1), U_MCU.39 (IO1)
EXP_IO2: J_EXP.4 (IO2), U_MCU.38 (IO2)
EXP_IO13: J_EXP.5 (IO13), U_MCU.21 (IO13)
EXP_IO38: J_EXP.6 (IO38), U_MCU.31 (IO38)
EXP_IO39: J_EXP.7 (IO39), U_MCU.32 (IO39)
EXP_IO40: J_EXP.8 (IO40), U_MCU.33 (IO40)
EXP_IO41: J_EXP.9 (IO41), U_MCU.34 (IO41)
EXP_IO42: J_EXP.10 (IO42), U_MCU.35 (IO42)
FB: C_FF.2, R_FBB.1, R_FBT.2, U_BUCK.4 (FB)
GW_G: Q_WW.1 (G), R_GW.1, R_PDW.1
LEDCW: R_GC.2, U_MCU.20 (IO12)
LEDC_D: D_CLC.A, J_LED.3 (C), Q_CW.3 (D)
LEDWW: R_GW.2, U_MCU.19 (IO11)
LEDW_D: D_CLW.A, J_LED.2 (W), Q_WW.3 (D)
MOT_U: J_MOTOR.1 (U), U_DRV.5 (OUT1)
MOT_V: J_MOTOR.2 (V), U_DRV.8 (OUT2)
MOT_W: J_MOTOR.3 (W), U_DRV.9 (OUT3)
NFAULT: R_NFAULT.2, U_DRV.18 (!FAULT), U_MCU.9 (IO16)
NRESET: R_NRESET.2, U_DRV.16 (!RESET)
NSLEEP: R_NSLEEP.2, U_DRV.17 (!SLEEP), U_MCU.7 (IO7)
P3V3: C_FF.1, C_MCU1.1, C_MCU2.1, C_MCU3.1, C_MCU4.1, C_MCU_BULK.1, C_OUT1.1, C_OUT2.1, C_SENS.1, D_MCU.C, J_EXP.1 (3V3), J_PROG.1 (3V3), J_SENSOR.1 (VCC), L1.2, R_AZ_A.1, R_AZ_B.1, R_AZ_C.1, R_BOOT.1, R_EN.1, R_EN_DRV.1, R_FBT.1, R_NFAULT.1, R_NRESET.1, R_NSLEEP.1, U_MCU.2 (3V3)
P24: C_IN1.1, C_IN2.1, C_IN_BULK.1, C_VCP.2, C_VM1.1, C_VM2.1, C_VM_BULK.1, D_CLC.C, D_CLW.C, D_OR_USB.C, D_Q1.C, J_LED.1 (VP), Q1.2 (S), R_ENB.1, TVS1.C, U_BUCK.3 (VIN), U_DRV.4 (VM), U_DRV.11 (VM)
P24_F: F1.2, Q1.3 (D)
P24_RAW: F1.1, J_PWR.1 (VP)
PWMA: U_DRV.27 (IN1), U_MCU.4 (IO4)
PWMB: U_DRV.25 (IN2), U_MCU.5 (IO5)
PWMC: U_DRV.23 (IN3), U_MCU.6 (IO6)
Q1G: D_Q1.A, Q1.1 (G), R_Q1.1
ROTA: J_KNOB.1 (A), U_MCU.12 (IO8)
ROTB: J_KNOB.2 (B), U_MCU.17 (IO9)
STAT: R_STATUS.1, U_MCU.23 (IO21)
STAT_A: LED_STATUS.A, R_STATUS.2
SW: C_BOOT_B.2, L1.1, U_BUCK.2 (SW)
U0RXD: J_PROG.6 (RXD), U_MCU.36 (RXD0)
U0TXD: J_PROG.5 (TXD), U_MCU.37 (TXD0)
USBDM_RAW: D_USB.1 (I/O1_IN), D_USB.6 (I/O1_OUT), J_USB.A7 (DN1), J_USB.B7 (DN2), R_DM.1
USBDP_RAW: D_USB.3 (I/O2_IN), D_USB.4 (I/O2_OUT), J_USB.A6 (DP1), J_USB.B6 (DP2), R_DP.1
USB_DM_MCU: R_DM.2, U_MCU.13 (IO19)
USB_DP_MCU: R_DP.2, U_MCU.14 (IO20)
VBUS: C_VBUS.1, D_OR_USB.A, D_USB.5 (VBUS), J_USB.A4_B9 (VBUS), J_USB.B4_A9 (VBUS)
VCP: C_VCP.1, U_DRV.3 (VCP)

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
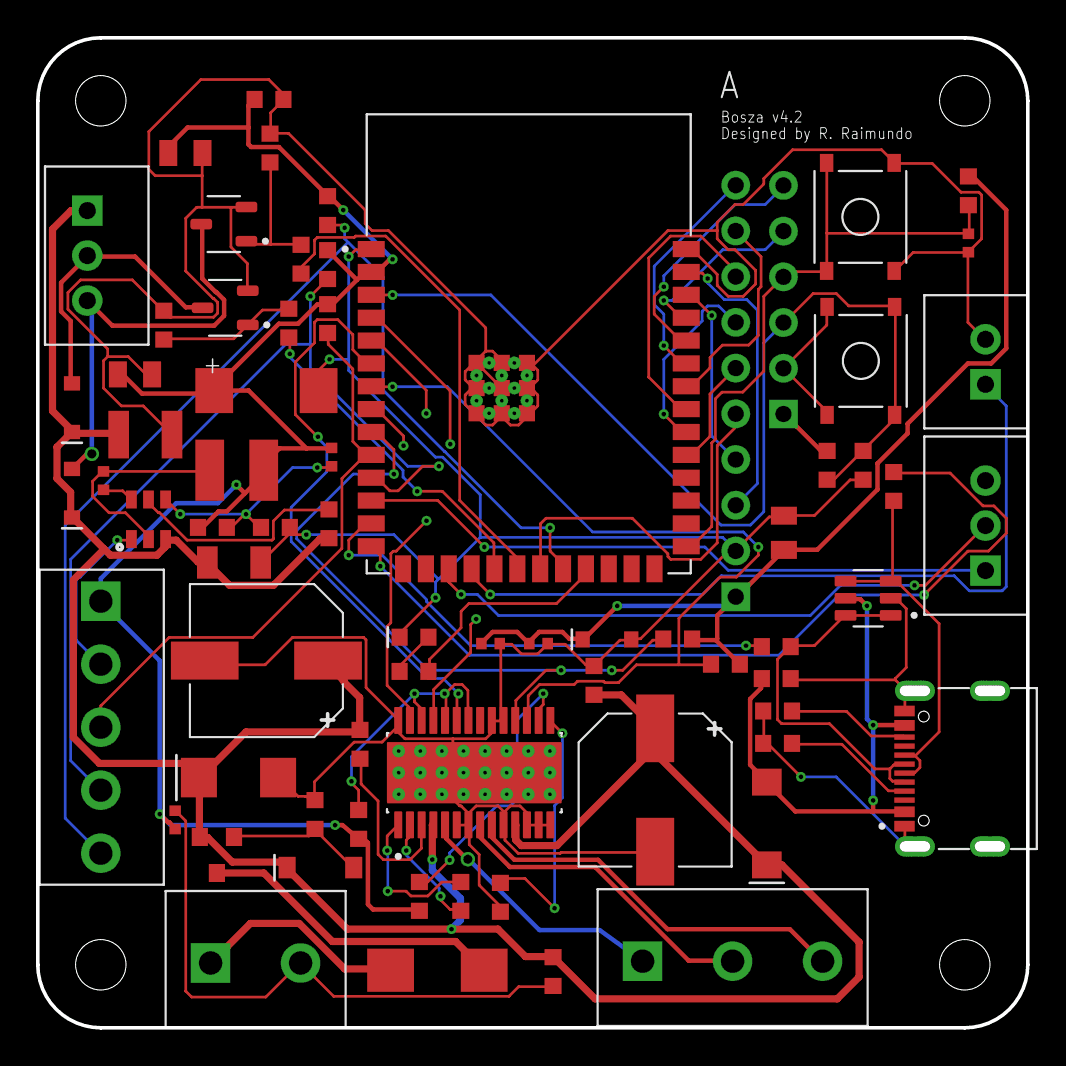
[picture p15: board BrushlessLamp.brd from above]

Board: 4 copper layers, 55.0 x 55.0 mm, 71 parts (0 on the bottom side), 57 nets.
