RoodsBurger/brushless_lamp/s3/firmware/main/main.cpp

// BrushlessLamp firmware: ColorTemperatureLight Matter endpoint + knob/button local control.

#include <Arduino.h>
#include <driver/gpio.h>
#include <esp_app_desc.h>
#include <esp_private/rtc_clk.h>
#include <esp_system.h>
#include <freertos/FreeRTOS.h>
#include <freertos/task.h>
#include <nvs_flash.h>

#include "config.h"
#include "input.h"
#include "leds.h"
#include "matter_app.h"
#include "motor.h"
#include "ota.h"
#include "pins.h"
#include "status_led.h"

static const char *reset_reason_str(esp_reset_reason_t r) {
    switch (r) {
    case ESP_RST_POWERON:    return "POWERON";
    case ESP_RST_EXT:        return "EXT";
    case ESP_RST_SW:         return "SW";
    case ESP_RST_PANIC:      return "PANIC";
    case ESP_RST_INT_WDT:    return "INT_WDT";
    case ESP_RST_TASK_WDT:   return "TASK_WDT";
    case ESP_RST_WDT:        return "WDT";
    case ESP_RST_DEEPSLEEP:  return "DEEPSLEEP";
    case ESP_RST_BROWNOUT:   return "BROWNOUT";
    case ESP_RST_SDIO:       return "SDIO";
    default:                 return "UNKNOWN";
    }
}

extern "C" void app_main() {
    // Park DRV8313 asleep before the bootloader release window so its 100 µA
    // quiescent draw doesn't blip 3V3 during external-power brown-in.
    gpio_set_direction((gpio_num_t)PIN_NSP, GPIO_MODE_OUTPUT);
    gpio_set_level((gpio_num_t)PIN_NSP, 0);

    // Custom board: status LED solid from power-on; state patterns take over once Matter is up.
    status_led_init();

#if !defined(BRUSHLESSLAMP_BOARD_TEYLETEN) && !defined(BRUSHLESSLAMP_BOARD_CUSTOM)
    // XIAO on-board user LED is active-LOW on GPIO 21; drive HIGH = off.
    // (Teyleten has no LED; the custom board's LED is driven by status_led.cpp.)
    gpio_set_direction((gpio_num_t)PIN_XIAO_USER_LED, GPIO_MODE_OUTPUT);
    gpio_set_level((gpio_num_t)PIN_XIAO_USER_LED, 1);
#endif

    // Hold a BBPLL consumer so USB-Serial-JTAG SOF auto-removal doesn't park the PLL on host-less boot.
    rtc_clk_bbpll_add_consumer();

    esp_err_t err = nvs_flash_init();
    if (err == ESP_ERR_NVS_NO_FREE_PAGES || err == ESP_ERR_NVS_NEW_VERSION_FOUND) {
        ESP_ERROR_CHECK(nvs_flash_erase());
        ESP_ERROR_CHECK(nvs_flash_init());
    }

    initArduino();
    delay(500);

    printf("\n=== BrushlessLamp (S3) ===\n");
    printf("[boot] reset_reason=%s (%d)\n",
           reset_reason_str(esp_reset_reason()), (int)esp_reset_reason());
    printf("[boot] firmware v%s\n", esp_app_get_description()->version);

    motor_set_settle_callback(matter_push_level_from_angle);

    // Matter (BLE/Wi-Fi/CHIP) must come up before the FOC busy-wait pegs core 1, or CSRRequest times out (CHIP_ERROR_TIMEOUT 32).
    leds_init();
    matter_app_init();
    status_led_set_matter_ready();
    leds_start_fader();
    motor_init_and_start();
    input_init();
    input_task_start();
    ota_start();   // background signed-OTA poller (checks GitHub Releases manifest)

    printf("Ready. Knob = %.2f rad/detent | 1x=on/off | 2x=cycle mode (motor/brightness/CT) | 3x=speed | hold 5s=re-home | 15s=factory reset\n",
           KNOB_STEP_RAD);

    vTaskDelete(nullptr);
}
