RoodsBurger/brushless_lamp/s3/firmware/main/ota.cpp

// Self-hosted signed OTA over HTTPS. A low-priority task on CORE_OTHERS polls a
// small JSON manifest on GitHub Releases; when its version exceeds the running
// firmware it downloads the image via esp_https_ota (which verifies the RSA
// signature before writing the spare slot), then reboots once the lamp is idle.
//
// GitHub Releases assets answer with a 302 to a short-lived presigned CDN URL,
// and esp_http_client/esp_https_ota don't auto-follow that cross-host redirect.
// So resolve_url() does the redirect hop itself (HEAD → Location), and both the
// manifest fetch and the image download use the final presigned URL directly.

#include <freertos/FreeRTOS.h>
#include <freertos/task.h>
#include <esp_log.h>
#include <esp_system.h>
#include <esp_http_client.h>
#include <esp_https_ota.h>
#include <esp_crt_bundle.h>
#include <cJSON.h>
#include <string.h>
#include <strings.h>

#include "ota.h"
#include "config.h"
#include "motor.h"

static const char *TAG = "ota";

// Compiled-in board name; the manifest must carry a matching "board" field or the
// update is refused — a published binary for another board must never be staged
// (its pin map would cripple every peripheral).
#if defined(BRUSHLESSLAMP_BOARD_CUSTOM)
static const char *BOARD_NAME = "custom";
#elif defined(BRUSHLESSLAMP_BOARD_TEYLETEN)
static const char *BOARD_NAME = "teyleten";
#else
static const char *BOARD_NAME = "xiao";
#endif

// Captured Location header from a redirect, and the accumulated manifest body.
// All touched only from the single OTA task, so no locking needed.
static char s_location[1024];
static char s_manifest[512];
static int  s_manifest_len = 0;

static esp_err_t location_evt(esp_http_client_event_t *e) {
    if (e->event_id == HTTP_EVENT_ON_HEADER && e->header_key &&
        strcasecmp(e->header_key, "Location") == 0) {
        strncpy(s_location, e->header_value, sizeof(s_location) - 1);
        s_location[sizeof(s_location) - 1] = '\0';
    }
    return ESP_OK;
}

static esp_err_t manifest_evt(esp_http_client_event_t *e) {
    if (e->event_id == HTTP_EVENT_ON_DATA && e->data_len > 0) {
        int room = (int)sizeof(s_manifest) - 1 - s_manifest_len;
        int n = (e->data_len < room) ? e->data_len : room;
        if (n > 0) { memcpy(s_manifest + s_manifest_len, e->data, n); s_manifest_len += n; }
    }
    return ESP_OK;
}

// Follow one redirect hop (HEAD, auto-redirect off) and return the final URL in
// out. If the server answers 2xx directly, out = url unchanged.
static bool resolve_url(const char *url, char *out, size_t sz) {
    s_location[0] = '\0';
    esp_http_client_config_t cfg = {};
    cfg.url                  = url;
    cfg.crt_bundle_attach    = esp_crt_bundle_attach;
    cfg.event_handler        = location_evt;
    cfg.method               = HTTP_METHOD_HEAD;
    cfg.disable_auto_redirect = true;
    cfg.timeout_ms           = 15000;
    cfg.buffer_size          = 4096;   // GitHub's presigned Location header is ~700 B
    cfg.buffer_size_tx       = 2048;
    esp_http_client_handle_t c = esp_http_client_init(&cfg);
    if (!c) return false;
    esp_err_t err = esp_http_client_perform(c);
    int status = esp_http_client_get_status_code(c);
    esp_http_client_cleanup(c);
    if (err != ESP_OK) { ESP_LOGW(TAG, "resolve failed err=%s", esp_err_to_name(err)); return false; }
    if (status >= 300 && status < 400 && s_location[0]) {
        strncpy(out, s_location, sz - 1); out[sz - 1] = '\0';
    } else {
        strncpy(out, url, sz - 1); out[sz - 1] = '\0';
    }
    return true;
}

// GET + parse the manifest. Returns true and fills out_version / out_url on success.
static bool fetch_manifest(uint32_t *out_version, char *out_url, size_t url_sz) {
    char real[1024];
    if (!resolve_url(OTA_MANIFEST_URL, real, sizeof(real))) return false;

    s_manifest_len = 0;
    esp_http_client_config_t cfg = {};
    cfg.url               = real;
    cfg.crt_bundle_attach = esp_crt_bundle_attach;
    cfg.event_handler     = manifest_evt;
    cfg.timeout_ms        = 15000;
    cfg.buffer_size       = 4096;      // long presigned CDN URL in the request line
    cfg.buffer_size_tx    = 2048;
    esp_http_client_handle_t c = esp_http_client_init(&cfg);
    if (!c) return false;
    esp_err_t err = esp_http_client_perform(c);
    int status = esp_http_client_get_status_code(c);
    esp_http_client_cleanup(c);
    if (err != ESP_OK || status != 200) {
        ESP_LOGW(TAG, "manifest fetch failed err=%s status=%d", esp_err_to_name(err), status);
        return false;
    }

    s_manifest[s_manifest_len] = '\0';
    cJSON *root = cJSON_Parse(s_manifest);
    if (!root) { ESP_LOGW(TAG, "manifest parse failed"); return false; }
    cJSON *v = cJSON_GetObjectItem(root, "version");
    cJSON *u = cJSON_GetObjectItem(root, "url");
    cJSON *b = cJSON_GetObjectItem(root, "board");
    bool ok = cJSON_IsNumber(v) && cJSON_IsString(u) && u->valuestring;
    // Strict board match: a manifest without a board field, or for another board,
    // is never ours (pre-board-field manifests were XIAO builds).
    if (ok && !(cJSON_IsString(b) && b->valuestring && strcmp(b->valuestring, BOARD_NAME) == 0)) {
        ESP_LOGW(TAG, "manifest board '%s' != '%s' — refusing update",
                 (cJSON_IsString(b) && b->valuestring) ? b->valuestring : "(none)", BOARD_NAME);
        ok = false;
    }
    if (ok) {
        *out_version = (uint32_t)v->valueint;
        strncpy(out_url, u->valuestring, url_sz - 1);
        out_url[url_sz - 1] = '\0';
    }
    cJSON_Delete(root);
    return ok;
}

// Download + verify + stage the new image. esp_https_ota sets the boot partition
// on success; the caller reboots when the lamp is idle.
static bool download_and_stage(const char *url) {
    char real[1024];
    if (!resolve_url(url, real, sizeof(real))) return false;

    esp_http_client_config_t http = {};
    http.url               = real;
    http.crt_bundle_attach = esp_crt_bundle_attach;
    http.timeout_ms        = 30000;
    http.keep_alive_enable = true;
    http.buffer_size       = 4096;     // long presigned CDN URL in the request line
    http.buffer_size_tx    = 2048;

    esp_https_ota_config_t ota = {};
    ota.http_config = &http;

    ESP_LOGW(TAG, "OTA: downloading image");
    esp_err_t err = esp_https_ota(&ota);
    if (err == ESP_OK) { ESP_LOGW(TAG, "OTA: image verified + staged"); return true; }
    ESP_LOGE(TAG, "OTA: failed: %s", esp_err_to_name(err));
    return false;
}

static void ota_task(void *) {
    vTaskDelay(pdMS_TO_TICKS(OTA_INITIAL_DELAY_MS));   // let WiFi/Matter settle first
    while (true) {
        uint32_t latest = 0;
        char url[256];
        bool cycle_ok = false;
        if (fetch_manifest(&latest, url, sizeof(url))) {
            cycle_ok = true;
            ESP_LOGI(TAG, "manifest version=%u, running=%u", latest, (unsigned)OTA_FW_VERSION);
            if (latest > OTA_FW_VERSION) {
                cycle_ok = download_and_stage(url);
                if (cycle_ok) {
                    // Apply only when the core is physically down (LED off) AND the motor
                    // is parked + position saved — checking the real shaft angle, not Matter
                    // OnOff (which can read "off" while the core is still raised), so a reboot
                    // never lands mid-travel and corrupts the saved zero.
                    while (!motor_is_idle() || motor_get_shaft_angle() > OTA_REBOOT_MAX_ANGLE_RAD)
                        vTaskDelay(pdMS_TO_TICKS(2000));
                    ESP_LOGW(TAG, "core down + motor parked — rebooting into updated firmware");
                    vTaskDelay(pdMS_TO_TICKS(500));
                    esp_restart();
                }
            }
        }
        // Healthy cycle: sleep the full interval. Failed fetch/download: retry in
        // OTA_RETRY_DELAY_MS so a WiFi blip doesn't defer an update by days.
        // pdMS_TO_TICKS overflows its 32-bit intermediate for multi-day values on non-SMP
        // FreeRTOS (432e9 wraps to ~42 min); compute ticks in 64-bit — the result fits TickType_t.
        uint32_t delay_ms = cycle_ok ? OTA_CHECK_INTERVAL_MS : OTA_RETRY_DELAY_MS;
        vTaskDelay((TickType_t)((uint64_t)delay_ms * configTICK_RATE_HZ / 1000));
    }
}

void ota_start() {
    xTaskCreatePinnedToCore(ota_task, "ota", 8192, nullptr, 3, nullptr, CORE_OTHERS);
}
