RoodsBurger/brushless_lamp/s3/firmware/main/leds.h

#pragma once

#include <stdint.h>

// CCT LED driver: angle-curve fade on a 10 ms task, gamma-2.2 brightness, pulse task for button feedback.

void leds_init();
void leds_start_fader();

void     leds_set_colortemp(uint16_t mireds);
uint16_t leds_get_colortemp();
void     leds_nudge_colortemp(int16_t delta_mireds);
void     leds_nudge_max_duty(int16_t delta);

void leds_pulse(uint8_t count);
