RoodsBurger/brushless_lamp/s3/test_ble/main/main.c

// Bare-bones BLE-only repro for the external-power wedge.
//
// Boots, init NimBLE, start BLE advertising. A heartbeat task on core 0 toggles
// GPIO 21 every 200 ms — same liveness probe as the m4-matter build. NVS-
// persisted boot_dbg captures reset reason, prev_ckpt (at each beacon checkpoint
// through bring-up), and prev_evt (last NimBLE GAP event seen).
//
// If this build wedges on external power around the same relative point as
// m4-matter, the failure is below the application stack — in IDF/NimBLE/silicon.

#include <stdio.h>
#include <stdint.h>
#include <string.h>

#include "esp_log.h"
#include "esp_system.h"
#include "nvs_flash.h"
#include "nvs.h"
#include "driver/gpio.h"
#include "freertos/FreeRTOS.h"
#include "freertos/task.h"

#include "nimble/nimble_port.h"
#include "nimble/nimble_port_freertos.h"
#include "host/ble_hs.h"
#include "host/util/util.h"
#include "services/gap/ble_svc_gap.h"

static const char *TAG = "test_ble";

// On-board user LED (active-LOW) — same as m4-matter's heartbeat + beacon line.
#define LED_GPIO 21

// ----- boot_dbg NVS namespace (mirrors s3/m4-matter/main/main.cpp) ------------

static void boot_dbg_set(const char *key, uint32_t val) {
    nvs_handle_t h;
    if (nvs_open("boot_dbg", NVS_READWRITE, &h) != ESP_OK) return;
    nvs_set_u32(h, key, val);
    nvs_commit(h);
    nvs_close(h);
}

static void log_prev_reset_reason(void) {
    nvs_handle_t h;
    if (nvs_open("boot_dbg", NVS_READWRITE, &h) != ESP_OK) return;
    uint32_t prev_rst = 0xFF, boot_n = 0, prev_ckpt = 0, prev_evt = 0;
    nvs_get_u32(h, "last_rst",  &prev_rst);
    nvs_get_u32(h, "boot_n",    &boot_n);
    nvs_get_u32(h, "last_ckpt", &prev_ckpt);
    nvs_get_u32(h, "last_evt",  &prev_evt);
    uint32_t cur_rst = (uint32_t)esp_reset_reason();
    boot_n++;
    nvs_set_u32(h, "last_rst",  cur_rst);
    nvs_set_u32(h, "boot_n",    boot_n);
    nvs_set_u32(h, "last_ckpt", 0);
    nvs_set_u32(h, "last_evt",  0);
    nvs_commit(h);
    nvs_close(h);
    printf("[boot_dbg] cur_reset=0x%02X prev_reset=0x%02X boot#=%u prev_ckpt=%u prev_evt=0x%X\n",
           (unsigned)cur_rst, (unsigned)prev_rst, (unsigned)boot_n,
           (unsigned)prev_ckpt, (unsigned)prev_evt);
}

// Beacon: pulse GPIO 21 N times then persist last_ckpt=N to NVS.
static void beacon(uint8_t n) {
    for (uint8_t i = 0; i < n; i++) {
        gpio_set_level(LED_GPIO, 0);
        vTaskDelay(pdMS_TO_TICKS(40));
        gpio_set_level(LED_GPIO, 1);
        vTaskDelay(pdMS_TO_TICKS(60));
    }
    boot_dbg_set("last_ckpt", (uint32_t)n);
    vTaskDelay(pdMS_TO_TICKS(150));
}

// ----- BLE advertising ------------------------------------------------------

static uint8_t own_addr_type;

static int gap_event(struct ble_gap_event *event, void *arg);

static void start_advertising(void) {
    struct ble_gap_adv_params adv_params;
    struct ble_hs_adv_fields fields;

    memset(&fields, 0, sizeof fields);
    fields.flags = BLE_HS_ADV_F_DISC_GEN | BLE_HS_ADV_F_BREDR_UNSUP;
    fields.tx_pwr_lvl_is_present = 1;
    fields.tx_pwr_lvl = BLE_HS_ADV_TX_PWR_LVL_AUTO;

    int rc = ble_gap_adv_set_fields(&fields);
    if (rc != 0) {
        ESP_LOGE(TAG, "set_fields rc=%d", rc);
        return;
    }

    memset(&adv_params, 0, sizeof adv_params);
    adv_params.conn_mode = BLE_GAP_CONN_MODE_UND;
    adv_params.disc_mode = BLE_GAP_DISC_MODE_GEN;

    rc = ble_gap_adv_start(own_addr_type, NULL, BLE_HS_FOREVER,
                           &adv_params, gap_event, NULL);
    if (rc != 0) {
        ESP_LOGE(TAG, "adv_start rc=%d", rc);
    } else {
        printf("[test_ble] advertising started\n");
    }
}

static int gap_event(struct ble_gap_event *event, void *arg) {
    boot_dbg_set("last_evt", (uint32_t)event->type);
    printf("[test_ble] gap event type=%d\n", event->type);
    if (event->type == BLE_GAP_EVENT_ADV_COMPLETE ||
        event->type == BLE_GAP_EVENT_DISCONNECT) {
        start_advertising();
    }
    return 0;
}

static void on_sync(void) {
    beacon(5);
    int rc = ble_hs_util_ensure_addr(0);
    if (rc != 0) { ESP_LOGE(TAG, "ensure_addr rc=%d", rc); return; }
    rc = ble_hs_id_infer_auto(0, &own_addr_type);
    if (rc != 0) { ESP_LOGE(TAG, "infer_auto rc=%d", rc); return; }
    beacon(6);
    start_advertising();
    beacon(7);
}

static void on_reset(int reason) {
    ESP_LOGE(TAG, "host reset reason=%d", reason);
}

static void host_task(void *param) {
    nimble_port_run();   // returns only on nimble_port_stop()
    nimble_port_freertos_deinit();
}

// ----- heartbeat ------------------------------------------------------------

static void heartbeat_task(void *arg) {
    while (1) {
        gpio_set_level(LED_GPIO, 0);
        vTaskDelay(pdMS_TO_TICKS(20));
        gpio_set_level(LED_GPIO, 1);
        vTaskDelay(pdMS_TO_TICKS(180));
    }
}

// ----- main -----------------------------------------------------------------

void app_main(void) {
    gpio_set_direction(LED_GPIO, GPIO_MODE_OUTPUT);
    gpio_set_level(LED_GPIO, 1);

    // Match m4-matter: 2 s settle so USB-CDC re-enumerates before boot_dbg.
    vTaskDelay(pdMS_TO_TICKS(2000));

    esp_err_t err = nvs_flash_init();
    if (err == ESP_ERR_NVS_NO_FREE_PAGES || err == ESP_ERR_NVS_NEW_VERSION_FOUND) {
        nvs_flash_erase();
        nvs_flash_init();
    }

    log_prev_reset_reason();
    printf("\n=== BrushlessLamp test_ble ===\n");

    xTaskCreatePinnedToCore(heartbeat_task, "hb", 2048, NULL, 1, NULL, 0);

    beacon(1);
    err = nimble_port_init();
    if (err != ESP_OK) {
        ESP_LOGE(TAG, "nimble_port_init err=%d", err);
        return;
    }
    beacon(2);

    ble_hs_cfg.reset_cb = on_reset;
    ble_hs_cfg.sync_cb  = on_sync;
    ble_hs_cfg.store_status_cb = ble_store_util_status_rr;
    beacon(3);

    int rc = ble_svc_gap_device_name_set("brushless-test-ble");
    if (rc != 0) ESP_LOGE(TAG, "name_set rc=%d", rc);
    beacon(4);

    nimble_port_freertos_init(host_task);
    // After this point, host_task is running; on_sync() will fire when the
    // controller is ready, doing beacons 5/6/7.
}
