RoodsBurger/brushless_lamp/(commit log)

2026-04-17 Initial commit: M1 closed-loop FOC spin on ESP32-C3 + SimpleFOC Mini
    BLDC variant of CylinderLamp. ESP32-C3 SuperMini drives a SimpleFOC Mini
    (DRV8313) through a custom LEDCDriver3PWM (direct LEDC calls — works
    around a silent BLDCDriver3PWM failure on arduino-esp32 core 3.3.7).
    MT6701 ABZ encoder provides closed-loop velocity feedback.
    Includes latched-fault recovery via nSLEEP, idle-disable timer, stall
    detection, accel-limited velocity ramp, and a Commander interface for
    bench tuning (T/C/P/I/F/R/K/M/A/X).
    [BrushlessLamp.ino]
2026-04-17 Eliminate periodic motor click by spinning inside loop()
    Symptom was a hard "click" roughly once every two seconds at any motor
    speed where the electrical period sat near the stall window — at T50
    × 11 pole pairs (~11 ms electrical) the rotor swept through ~37 % of an
    electrical cycle while SVPWM was held frozen, then snapped to the new
    angle on resume.
    Root cause turned out not to be in this sketch at all. arduino-esp32
    runs loop() inside a FreeRTOS task that gets preempted by an
    unidentified background task for ~4 ms every 2 s on single-core
    variants (S2/C3/C6). Raising loopTask priority to 22 didn't help —
    the preempter sits at or above the esp_timer task. The known
    SimpleFOC-commun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
    [BrushlessLamp.ino]
2026-04-17 Document the M4 hw-timer refactor and known-issues references
    Future-self pointer: the current while(true) workaround for the
    arduino-esp32 single-core scheduler quirk has to come out before
    Matter/WiFi/BLE can land, since those depend on the FreeRTOS
    scheduler we're currently starving. Spelled out the refactor plan
    inline with the M4 roadmap entry so it's not lost.
    Added a Known issues / references section linking the SimpleFOC
    issue + community threads + hard-real-time docs that the click hunt
    turned up, plus the soft-float printf, DRV8313 nSLEEP latch, and
    USB-CDC monitor-reset constraints that this repo has already paid
    for in debugging time.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
2026-04-19 Port M1+M2 firmware to Seeed XIAO ESP32-C6
    Chip swap from the ESP32-C3 SuperMini. Two things change, one stays:
    - Pins remapped to the XIAO D-label layout. PWM A/B/C moved to D10/D9/D8
    (GPIO 18/20/19), EN to D7, nSLEEP to D6, nFAULT to D3, encoder A/B to
    D0/D1. All DRV8313 signals now sit on one side of the board, encoder
    + nFAULT on the other. None of the chosen pins are strapping on C6
    (C6 straps are GPIO 4/5/8/9, all internal to the XIAO).
    - Dropped the custom LEDCDriver3PWM class (~55 lines). It only existed
    because C3 has no MCPWM peripheral and the stock BLDCDriver3PWM on
    top of LEDC silently fails to produce voltage on arduino-esp32 3.3.7.
    C6 has MCPWM, SimpleFOC's def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
    [BrushlessLamp.ino]
2026-04-19 Update README for C6 and catch it up to M2 reality
    Chip-swap aside, the README had been narrating "M1: motor spin only,
    no encoder" long after M2 actually landed — it still listed a fake L
    command, claimed nSLEEP/nFAULT were unconnected, and promised a
    "M1: motor only" banner that hasn't matched what the firmware prints
    for weeks. Rewrote the current-state sections to describe what the
    sketch actually does now.
    Changes:
    - Hardware/wiring table rewritten around the XIAO D-label pinout and
    the real encoder + fault-line connections.
    - Build + upload commands updated to the XIAO_ESP32C6 fqbn.
    - Serial-commands section enumerates the actual Commander bindings
    (T/C/P/I/F/R/K/M/A/X) instead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
2026-04-20 Wire MT6701 Z index on D2 (GPIO 2)
    The C3 build had the Z wire physically connected to the breakout but
    never used it in software — `Encoder(A, B, cpr)` is the A+B-only
    constructor. Moving to the 4-arg form `Encoder(A, B, cpr, Z)` lets
    SimpleFOC latch the once-per-rev index pulse, which gives absolute
    single-turn position after the first Z after boot. Useful for
    eventual position-mode control and for skipping the initFOC alignment
    twitch once we can rely on a known-good angle reference.
    Added doZ() IRAM ISR, enableInterrupts(doA, doB, doZ), README wiring
    table now lists D2 → MT6701 Z.
    Still compiles clean (~500 B of growth for the new ISR).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
    [BrushlessLamp.ino]
2026-04-20 Clean up sketch comments and break a doA symbol collision
    Comments are now one-liners describing what the code does, not
    history/rationale. The wall-of-text pin-block comment, the while(true)
    rationale, the FX_HI/FX_LO soft-float explainer, and the scattered
    multi-line function headers all collapse to single lines. The
    ESP32-scheduler context that those longer blocks carried is in the
    README's Known-issues section, which is where it belongs.
    Also renamed the velocity-accel command handler `doA(char*)` to
    `doAccel(char*)`. The encoder ISR `void IRAM_ATTR doA()` kept its
    name, so the two functions were relying on C++ overload resolution
    by parameter list to disambiguate. That worked but is fr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
    [BrushlessLamp.ino]
2026-04-20 Sync README wiring + checklist to current C6 state
    Four rows in the wiring table were stale after the iterative pin-
    reduction pass: EN was still listed on D7 even though it's now
    hard-tied to 3V3 on the SimpleFOC Mini; nSLEEP was still on D6 even
    though it moved to D7 (re-using the old EN slot); and nFAULT/Z rows
    described signals that are no longer connected. The header paragraph
    above the table and the first-run checklist both referenced the old
    state too.
    Replaced the table with only the six GPIOs the firmware actually
    drives/reads plus the power pins. Added a dedicated callout for the
    3V3→EN jumper since forgetting that leaves the driver stuck disabled
    with no obvious symptom from th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
2026-04-20 M3a: rotary + button user input, position mode, trapezoidal profile
    Closed-loop FOC moves from velocity mode to angle/position mode so the
    rotary encoder can command a target shaft angle. The rotary knob, push
    button, and supporting machinery cover the user-facing half of M3 —
    LEDs and brightness control are deferred to M3b.
    Rotary input
    - PCNT peripheral decodes the quadrature knob on D2/D3 with a 10 µs
    hardware glitch filter — zero CPU cost, robust against contact
    bounce on cheap mechanical encoders. Internal pull-ups on the GPIOs
    avoid phantom counts when the encoder is disconnected.
    - Each detent (4x counts) adds RAD_PER_CLICK to the commanded
    position; negative direction w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
    [BrushlessLamp.ino]
2026-04-20 Document M3a: wiring, gestures, serial commands, boot behavior
    - Milestone heading now reflects M3a landing alongside M1/M2.
    - Wiring table adds D2/D3/D4 rows for the rotary knob A/B and push
    button, plus a row for the XIAO onboard LED (temporary warning
    indicator until M3b moves it to the lamp LEDs).
    - Encoder hardware bullet adds the PEC11-style rotary knob with
    integrated push-button as a separate user-input component.
    - Peripheral wiring section gets a full rotary-encoder block covering
    all five pins (A/B/common + button/GND).
    - New "User gestures" table spells out knob, single/double/long-hold
    behaviors including the speed-preset tuple and factory reset.
    - Note added explainin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
2026-04-20 M3b: CCT LED strip, brightness knob mode, position-gated on/off
    Adds the LED half of the user-facing control surface. Two AO3400A
    logic-level MOSFETs (low-side, no gate resistor — same bare circuit
    as CylinderLamp) switch the warm-white and cool-white channels of a
    24 V CCT strip that shares its anode with the motor rail. Gate drive
    from XIAO D5/D6 via LEDC at 25 kHz, 10-bit. All 11 broken-out GPIOs
    are now in use.
    Brightness path
    - `brightness` is 0..100 and runs through a 101-entry gamma LUT
    (γ=2.2) built once at setup, so the hot path is a straight lookup
    + two multiplies for the CCT split.
    - `cct` is 0..100 (0 = all WW, 100 = all CW). Not touched by the
    knob — exposed via the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
    [BrushlessLamp.ino]
2026-04-20 M3b polish: clamp accel ≥ 0.1, fix stale README gate threshold
    doAccel
    - Clamp `accel` to a minimum of 0.1 rad/s² in the 'A' command handler.
    Prevents a user-typed `A-5` or `A0` from making rampTarget's
    decel_dist (v² / 2a) divide by zero or invert the trapezoid sign.
    README first-run checklist step 4
    - Was still describing the old commanded-based 0.1 rad gate. Now
    matches the position-proportional fade: LEDs start fading in as
    measured shaft_angle crosses 0.5 rad and reach the configured
    brightness around 3 rad. CCW past 0.5 rad turns the lamp off.
    Compiled and flashed; clamp verified via serial with A-5 / A0 / A8.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
    [BrushlessLamp.ino]
2026-04-21 M4: Matter integration + FOC hw-timer ISR refactor
    Adds the remote-control layer so Google Home / Apple Home / Alexa /
    Home Assistant can drive the lamp's motor position and LED color
    temperature over Matter. Firmware changes:
    FOC → hardware timer ISR
    - motor.loopFOC() now runs from a 2 kHz hw_timer_t ISR (onFocTick).
    Commutation is decoupled from the main loop, so the single-core
    arduino-esp32 scheduler quirk that used to preempt loop() for ~4 ms
    every 2 s no longer affects SVPWM — the ISR keeps ticking regardless.
    - loop() returns normally again. while(true) removed. motor.move()
    stays in loop(); it's tolerant of the ~4 ms scheduler spikes (visible
    in maxLp) because motion_d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
    [BrushlessLamp.ino]
2026-04-21 Document the shared-QR commissioning-conflict gotcha
    The arduino-esp32 Matter library ships the same hardcoded VID / PID /
    discriminator / passcode for every build. If you already have another
    device built from the same library commissioned into your Matter
    fabric (e.g. a CylinderLamp), adding the BrushlessLamp fails at the
    network step with `Failsafe timer expired` — the commissioner thinks
    the new device collides with the existing node. Fix: decommission the
    old device first, then rescan the new one's QR.
    Found the hard way trying to pair BrushlessLamp while CylinderLamp
    was still in Google Home. README's Matter section now spells this
    out as a known limitation alongside the root cause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
2026-04-21 Stop releasing BLE post-commissioning — causes use-after-free on WiFi reconnect
    Ported the CylinderLamp "release BLE 3 s after commissioning" trick
    straight to the C6, along with linear brightness + effective_bri/cct
    smoothing + Matter callback logging. The BLE release was masking a
    latent problem in the arduino-esp32 Matter library: its internal WiFi
    reconnect recovery path dereferences a structure that lives in the
    memory esp_bt_mem_release(ESP_BT_MODE_BLE) hands back. On the next
    WiFi hiccup the chip faulted on Core 0 at MEPC 0x40802e7a and
    rebooted. Across three boots in a row the device never finished
    Matter post-connect — the lamp looked like it was "flashing" because
    the chip was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
    [BrushlessLamp.ino]
2026-04-21 M4 stability: boot-loop recovery + FOC ISR drop + task watchdog + sync gate
    Work around a known arduino-esp32 Matter bug on the C6 where the
    library's WiFi-reconnect error path dereferences a null struct
    (Load-access fault at MTVAL 0x000000a8 inside chip[DL] after
    esp_wifi_connect fails). Upstream tracked at
    connectedhomeip#26052, esp-matter#672, esp-matter#1682. We can't fix
    the library without forking; this change makes the device survive the
    crash instead.
    Changes
    - Boot-reason-based crash counter in a new "boot" NVS namespace.
    esp_reset_reason() classifies the previous boot (PANIC / TASK_WDT /
    INT_WDT are crashes; POWERON / SW / USB are normal). Three
    consecutive crashes trigger n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
    [BrushlessLamp.ino]
2026-04-21 Tune for Matter responsiveness: shrink POS_MAX to 30 rad, default speed idx 3
    Root cause of "unresponsive" in Google Home: with POS_MAX=1000 rad
    (testing placeholder) and the default 15 rad/s speed preset, Matter
    brightness=100 → commanded=279 rad takes ~19 s for the motor to reach.
    Turn it off → 19 s back. That's why the lamp felt dead: commands were
    landing, motor was seeking, just taking forever.
    Tightening POS_MAX to 30 rad makes full brightness travel ~1.2 s at the
    top-preset 25 rad/s (and a tolerable 3 s at the slowest 10 rad/s). This
    is the range the mechanics end up wanting anyway — 30 rad is close to
    a full revolution scaled for gimbal pole pairs. Can widen later if the
    final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
    [BrushlessLamp.ino]
2026-04-21 Native ESP-IDF + esp-matter migration (phases 0-4) with PR#42320
    Replaces the Arduino build with a native ESP-IDF v5.4.4 + esp-matter
    release/v1.5 project under esp-idf/. Cherry-picks connectedhomeip
    PR#42320 (saved as a re-appliable patch) to fix the upstream chip[DL]
    WiFi-reconnect crash that was making commissioning unreliable on C6.
    Structure
    - esp-idf/main/app_main.cpp — entry + Matter endpoint wiring
    - esp-idf/main/app_driver.cpp — Matter ↔ motor/LED/knob bridge
    - esp-idf/main/motor.cpp — esp_simplefoc on MCPWM + GPTimer FOC ISR
    - esp-idf/main/leds.cpp — dual-channel CCT via LEDC
    - esp-idf/main/input.cpp — PCNT knob + polled button state ma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
    [partitions.csv]
2026-04-21 Motor-only IDF build: smooth M3b-parity baseline, Kconfig-gated
    Adds a CONFIG_APP_MATTER_ENABLED Kconfig flag so the Matter stack /
    WiFi / BLE code paths can be compile-gated out, producing a 405 KB
    diagnostic firmware that matches Arduino M3b's pre-Matter behavior.
    This isolates motor control from Matter's CPU/ISR pressure so we can
    lock in a known-smooth motor baseline before layering Matter back on.
    Build:
    idf.py -DSDKCONFIG_DEFAULTS="sdkconfig.defaults;sdkconfig.defaults.esp32c6;sdkconfig.defaults.motor_only" build
    Motor architecture matches Arduino M3b exactly:
    - Sequential motor.loopFOC() + motor.move() in app_loop_task, no
    GPTimer ISR (putting both in an ISR blocked MT6701 GPIO-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
2026-04-21 IDF+Matter motor: restore torque, smooth feel, match M4 stability pattern
    Phase 5 iteration on the esp-idf + esp-matter port. Motor now feels close to
    the Arduino M4 baseline under Matter load.
    Local override at esp-idf/components/espressif__arduino-foc (2.3.0~3 source
    with targeted 2.4.0 backports):
    - BLDCMotor.cpp KV_rating fix (drop erroneous *√2)
    - Sensor.cpp: reject negative angles, handle micros() overflow, precision-
    protect velocity integration across full_rotation boundaries
    Motor control (motor.cpp):
    - Skip phase_resistance assignment so 2.3.0 voltage-mode matches 2.4.0:
    PID_velocity.limit = voltage_limit (~12 V) instead of current_limit
    (0.5 A), and voltage.q = current_s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
    [BrushlessLamp.ino, config.h, leds.cpp, motor.cpp, motor.h]
2026-04-22 IDF+Matter motor: 25 kHz PWM, CylinderLamp range, fix per-edge anchor race
    Phase 6+7 iteration on top of 199be37. Motor + LEDs feel close to M4 now;
    two known remaining issues (stall sensitivity, idle holding torque) flagged
    for the next round.
    Audibility (Phase 6a):
    - New local override at esp-idf/components/espressif__esp_simplefoc/ — same
    source as the 1.2.3 managed component, patched to bump _PWM_FREQUENCY from
    20 kHz (audible) to 25 kHz (matches Arduino M4, inaudible). Upstream's
    BLDCDriver3PWM ignores the user-set pwm_frequency member and uses this
    macro for the MCPWM period_ticks calculation, so the Phase 5 setting
    in motor.cpp had been silently dropped.
    LED on/off (Phas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
    [config.h, leds.cpp, motor.cpp]
2026-04-22 IDF Phase 9: cap motor voltage at 8V + smoother velocity LPF (quieter)
    User feedback: "this is a brushless motor, should be near silent. there is
    some audible resonance." Investigation:
    - 4015 motor has 5 Ω phase resistance; SimpleFOC Mini docs explicitly
    recommend >10 Ω. With our default 12 V PID-output cap, peak coil current
    was 2.4 A — at the DRV8313's 2.5 A rating, producing significant coil
    whine + magnetostriction.
    motor.cpp: explicit g_motor.voltage_limit = 8.0f. Caps PID output at 8 V
    → 1.6 A peak through the 5 Ω motor (well below 2.5 A rating). Driver bus
    voltage stays at 24 V so SVPWM still has full headroom; only the setpoint
    is clamped. Result: noticeably quieter a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
2026-04-22 Phase 14a: IDF + arduino-as-component + upstream SimpleFOC v2.4.0 — motor-only
    Scraps 13 phases of fighting Espressif's esp_simplefoc 1.2.3 fork (arduino-foc
    2.3.0~3 underneath) and restarts on the configuration that finally matches the
    M2-knob Arduino reference: native ESP-IDF hosts the build, arduino-esp32 comes
    in as an IDF component via the Component Manager, and upstream SimpleFOC
    v2.4.0 is cloned verbatim into components/SimpleFOC/.
    Hardware-verified silent + strong torque (user-confirmed; could not induce a
    stall at tgt=30 rad/s). Steady-state tracking: vel within 0.5 rad/s of target,
    maxLp 720–1077 us vs the M2-knob Arduino reference's 1362 us.
    Notable choices in 14a:
    - No esp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
    [partitions.csv]
2026-04-22 Phase 14b: dual-channel CCT LEDs on LEDC, binary 2 Hz angle follower
    Adds main/leds.{cpp,h} with arduino-esp32 3.x LEDC pin-based API (ledcAttach)
    at 25 kHz / 8-bit resolution on PIN_LED_WW=23 and PIN_LED_CW=16. Public API:
    leds_init() / leds_set(warm, cool) / leds_start_angle_follower().
    The follower is deliberately dumb — polls motor_get_shaft_angle() at 2 Hz and
    flips both channels to a fixed 12.5 % duty when |angle| > 5 rad, else off,
    writing LEDC only on transitions. A 30 Hz sinf()-driven WW/CW balance task
    looked like it starved the FOC loop enough to drop torque under commanded
    velocity; the motor would start spinning then stall at ~4 revolutions while
    the PID's output was already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
    [leds.cpp, leds.h, main.cpp]
2026-04-22 Phase 14c: Matter ColorTemperatureLight + angle-mode position control
    End-to-end Matter slider → motor position + LEDs on XIAO C6 with arduino-as-IDF-
    component + SimpleFOC v2.4.0 + esp-matter release/v1.5. Best-working version to
    date: commissioning via Apple Home, motor reaches target with no overshoot, LEDs
    turn on/off based on physical shaft angle.
    Control architecture:
    - SimpleFOC stays in M2-proven *velocity mode* (PID P=0.2/I=20 at LPF_TF=0.02, the
    quiet tuning). An app-layer trapezoidal profile closes the position loop: for the
    current shaft angle it computes the maximum velocity that still allows braking
    to the target in time —
    max_safe_vel = sqrt(2 · MOTION_ACCEL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
    [config.h, input.cpp, leds.cpp, main.cpp, matter_app.cpp, matter_app.h, motor.cpp, motor.h]
2026-04-23 Phase 14c refinements: linear+physics profile, M2-pattern idle disable, knob→Matter deferred push, attribute echo suppression
    Iterated on the motion feel. Final state before the S3 migration:
    - Motion profile is min(MOTION_VELOCITY, P_POSITION·|err|, sqrt(2·MOTION_ACCEL·|err|))
    — linear term dominates near the target for a smooth asymptotic stop, physics
    term guarantees braking in time far out, MOTION_VELOCITY caps top speed. No
    hard deadband cutoff → no "snap" as the motor reaches the target.
    - Brake-on-reverse: opposite-direction targets force commanded_vel=0 first, then
    accelerate into the new direction once commanded has crossed zero.
    - Idle disable mirrors M2-knob's pa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
    [config.h, input.cpp, matter_app.cpp, motor.cpp, motor.h]
2026-04-23 Phase 15: XIAO ESP32-C6 → XIAO ESP32-S3 port, staged M1–M4 projects
    Ported the Phase 14c control stack from the single-core C6 to the dual-core + FPU
    S3. The user will drop the XIAO S3 into the existing mechanical harness tomorrow;
    the breakout is wired by XIAO D-label so only GPIO numbers shift, not the
    physical connections.
    Research confirmed everything we earned the hard way on C6 carries over verbatim:
    - PR#42320 (WiFi-reconnect crash) — still required until esp-matter bumps its chip
    submodule past c2ad2a5. Fault shape differs (MTVAL on RISC-V C6 vs
    LoadProhibited on Xtensa S3) but root cause is the same platform-layer race.
    - chip manifest pins (esp_insights ^1.2.4 → 1.2.2,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
    [partitions.csv]
2026-04-23 S3 M1: busy-wait 200 µs FOC loop matches M2-knob audibility
    Direct-port on S3 hardware was much louder than the C6 M2-knob reference
    because the FPU made loopFOC() run ~50 kHz free-running; the quiet
    C6 baseline was naturally ~5 kHz from softfloat. Hold the same 200 µs
    period explicitly via micros() busy-wait, pin the task to core 1, and
    let IDLE starve (esp_task_wdt_delete on CORE_MOTOR's idle task).
    Also: swap main/REQUIRES from brushlesslamp_core → common (IDF uses
    directory name as component name), disable PSRAM for M1 (XIAO S3R8
    needs Octal, not Quad), and add direct-velocity manual mode for the
    audibility sweep.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
    [main.cpp, motor.cpp, motor.h]
2026-04-23 S3 M2: knob velocity-nudge (±10 rad/s per detent, cap ±50, button → 0)
    M2 reuses M1's manual-velocity path (motor_run_at_velocity), so it
    inherits the same 200 µs busy-wait FOC loop + MOTION_ACCEL trapezoidal
    ramp + idle-disable. Each knob detent accumulates ±KNOB_STEP_RAD_PER_SEC
    into a clamped target velocity; the button zeroes it.
    Also: disable PSRAM in M2's sdkconfig (XIAO S3R8 needs Octal not Quad,
    same fix as M1).
    [config.h, input.cpp, main.cpp]
2026-04-23 S3 M3: CylinderLamp controls, angle-driven LED fade, hardware audibility tune
    Controls ported from CylinderLamp: single-click toggles brightness mode
    (knob → LED max duty in brightness mode; target angle in motor mode),
    double-click cycles MOTION_VELOCITY_PRESETS with pulse-count feedback,
    5 s hold warns with 5 pulses, 9 s hold erases NVS and restarts.
    LED brightness is a continuous function of shaft angle — linear ramp
    0..LED_FADE_ANGLE_RAD, gamma-2.2 on max_duty so knob nudges in brightness
    mode feel perceptually even. A 10 ms linear fader covers discontinuous
    target changes (on/off, max_duty steps). Pulse feedback runs in a
    short-lived task that preempts the fader via a flag.
    Motor: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
    [config.h, input.cpp, leds.cpp, leds.h, main.cpp, motor.cpp, motor.h]
2026-04-23 S3 M4: Matter commissioning works + CylinderLamp controls + NVS persistence
    Matter + BLE pairing works end-to-end on S3. Key fixes:
    - Override weak btInUse() in matter_app.cpp so Arduino's initArduino() does
    NOT call esp_bt_controller_mem_release() — without this, the controller's
    memory is freed into the heap and bt_controller_init crashes on malloc
    (LoadProhibited during r_llm_env_init). Matches the Rainmaker + Matter
    co-existence pattern.
    - Remove CONFIG_ENABLE_ESP32_FACTORY_DATA_PROVIDER until phase-16 cred flow
    — when no factory partition is flashed, GetSetupDiscriminator fails and
    the BLE advert gets the wrong discriminator, making controllers unable
    to discover the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
    [config.h, input.cpp, leds.cpp, leds.h, main.cpp, matter_app.cpp]
2026-04-23 S3 M4: cached sensor_direction, soft stall, 100% push fix, 18 V headroom
    Motor:
    - Persist sensor_direction to NVS after first successful initFOC() and skip
    the 1000-step forward/reverse rotation sweep on subsequent boots (the
    audibly loud part of alignment). zero_electric_angle deliberately NOT
    cached because the MT6701 runs in incremental quadrature mode and its
    angle_prev starts at 0 every boot regardless of physical rotor position,
    so a stale zero_electric_angle produces Uq in the wrong direction → no
    torque (reproduced in an earlier attempt).
    - Stall detection per user spec — just stop, idle, push position to Matter.
    If |commanded_vel| > 0.2 rad/s and |shaft_vel| stays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
    [config.h, matter_app.cpp, motor.cpp]
2026-04-23 S3 M4: per-device Matter identity + LED pulse/fade polish
    Per-device factory data (esp-matter-mfg-tool):
    - Pin esp_secure_cert_mgr to 2.5.0 in main/idf_component.yml — 2.9.x
    dropped esp_secure_cert_get_priv_key() which CHIP's DAC provider still
    calls (connectedhomeip#31382, esp-matter#798).
    - sdkconfig turns on the factory-data path: ENABLE_ESP32_FACTORY_DATA_PROVIDER,
    ENABLE_ESP32_DEVICE_INSTANCE_INFO_PROVIDER, SEC_CERT_DAC_PROVIDER,
    FACTORY_COMMISSIONABLE_DATA_PROVIDER. CHIP_FACTORY_NAMESPACE_PARTITION_LABEL
    is "fctry" (the partitions.csv label) so the provider reads the right NVS.
    - Explicitly disable ESP_SECURE_CERT_DS_PERIPHERAL and ESP_SECURE_CERT_SUPPORT_
    LEGACY_FORMATS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
2026-04-23 S3 M4 cleanup: real bugs, dead code, comment hygiene, README rewrite
    Bugs:
    - matter_app.cpp: add volatile to s_on_off / s_level / s_color_temp_mireds /
    s_endpoint_id. CHIP task writes, motor + fader tasks read; without volatile
    the compiler can hoist the load across loop iterations.
    - matter_app.cpp: __attribute__((used)) on the btInUse() weak override so LTO
    can't drop it.
    - motor_run_at_velocity(0) now resyncs s_target_angle to the current shaft so
    pos_err=0 when the position loop takes over — was leaving a stale target
    that could cause a sudden slew on exiting manual mode.
    - matter_app.cpp: after PrintOnboardingCodes, log the live VID/PID/
    discriminator read back through the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
    [config.h, input.cpp, input.h, leds.cpp, matter_app.cpp, motor.cpp, motor.h]
2026-04-23 S3 M4: wipe foc_cal / leds / input NVS on factory reset
    esp_matter::factory_reset() only clears CHIP's own NVS (chip-config,
    chip-counters, KVS) — it doesn't touch our foc_cal / leds / input
    namespaces. Result: after a Matter factory reset (button-hold or Home-app
    "Remove device") the cached sensor_direction stayed in NVS, initFOC
    skipped the direction sweep on the next boot, and only the 700 ms
    zero-angle pulse ran. On certain rotor resting positions that short
    pulse alone wasn't enough to finish alignment and the motor barely
    moved afterwards.
    Fix: matter_wipe_local_nvs() clears the three app namespaces, and is
    invoked from both reset paths:
    - input.cpp's 9 s button-hold, right before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
    [input.cpp, matter_app.cpp, matter_app.h]
2026-04-23 S3 M4: commissioning reliability — WiFi + IPv6 + CHIP + MRP tuning
    Reduces the IM:ReportData retransmit-failure pattern we hit during
    Google Home commissioning, where the controller subscribes to all
    attributes immediately after CASE session establishment and the default
    WiFi RX buffers / CHIP handler limits / MRP retransmit budget don't
    survive the burst → session drops to kDefunct and the Home app reports
    "Accessory not responding".
    WiFi RX:
    CONFIG_ESP_WIFI_STATIC_RX_BUFFER_NUM=16 (from 10)
    CONFIG_ESP_WIFI_DYNAMIC_RX_BUFFER_NUM=48 (from 32)
    CONFIG_ESP_WIFI_RX_BA_WIN=16 (from 6)
    Matches the esp-matter light example's production tuning.
    BLE:
    CONFIG_BT_NIMBLE_ME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
2026-04-23 S3 M4: 240 MHz CPU + BLE DLE + tightened sdkconfig comments
    Root-cause fix for the remaining Matter commissioning flakiness that survived
    the earlier WiFi / IPv6 / CHIP / MRP tuning:
    CONFIG_ESP_DEFAULT_CPU_FREQ_MHZ_240=y
    CONFIG_ESP32S3_DEFAULT_CPU_FREQ_240=y
    The ESP-IDF default is 160 MHz. At that clock software ECDSA ran ~50 %
    slow — PASE_Pake2 took 822 ms and CSRRequest keypair took 530 ms, both
    visible as 'Long dispatch time' warnings in the CHIP log. That pushed
    past the commissioner's per-step timeout and triggered CHIP_ERROR_TIMEOUT
    (32) during the CSRRequest → ArmFailSafe step. At 240 MHz those fall
    back to ~550 ms / ~350 ms, comfortably inside the budget. The earlier
    "works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
2026-04-24 S3 M4: quiet default log level — fixes commissioning when no serial monitor
    USB-CDC console (usb_serial_jtag_vfs.c) blocks per-byte up to 50 ms when
    no host is reading TX. Matter's INFO chatter during PASE/AddNOC pushed
    the CHIP task into that backpressure and timed commissioning out. The
    symptom was "works with serial monitor open, fails without" — the Mac
    drains the TX buffer instantly when the port is open.
    LOG_DEFAULT_LEVEL=WARN + CHIP_DETAIL_LOGGING=n cuts the bulk of the TX
    volume so the stall doesn't accumulate. LOG_MAXIMUM_LEVEL=DEBUG from
    common stays, so raising the runtime level still works for debugging.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
2026-04-24 S3 M4: boot power-stabilization + kill boot LED flash
    Early in app_main, before NVS / Arduino init, force DRV8313 nSLEEP LOW
    and LED_WW / LED_CW LOW. nSLEEP has an external pullup so the driver
    would otherwise wake from POR with floating PWM inputs, and GPIO43
    (LED_CW) is UART0 TX — bootloader idle-HIGH left the lamp visibly lit
    for ~1.5 s on every reboot.
    Bump the post-initArduino delay from 500 ms to 1500 ms so the MP1584EN
    output + VBUS bulk cap settle before Matter's BLE advertiser and the
    motor sensor-align sweep pull ~300 mA and ~1.2 A respectively.
    Warm-boot NimBLE-vs-WiFi shutdown race in CHIP's BLEManagerImpl
    (already-commissioned path) still fires ~1/3 of reboots; the panic
    aut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
    [main.cpp]
2026-04-24 S3 M4: revert LED-pin boot-LOW — did not silence the flash
    Driving GPIO6 (LED_WW) and GPIO43 (LED_CW) LOW pre- or post-initArduino
    did not eliminate the visible boot flash, and the post-initArduino
    variant coincided with extra warm-boot crashes. The flash is cosmetic
    and comes from the bootloader phase (ROM + 2nd-stage); keep the driver
    and LED pins at their default boot state and accept the flicker.
    Keeps the nSLEEP LOW + delay(1500) power-stabilization changes from
    the parent commit intact.
    [main.cpp]
2026-04-24 S3 M4: reshuffle knob button — on/off, mode toggle, speed cycle
    New semantics:
    1 click → Matter OnOff toggle; off snaps motor to 0, on restores to the
    last commanded level (Google-Home-style, via new
    matter_push_onoff that mirrors apply_state)
    2 clicks → knob mode toggle (motor angle ↔ LED brightness), 2-blink pulse
    3 clicks → cycle MOTION_VELOCITY_PRESETS, (idx+1)-blink pulse
    Speed presets drop from {8, 15, 25, 40} to {15, 25, 40} — the 8 rad/s
    preset was too slow to feel responsive. MOTION_VELOCITY default goes
    from 8 → 15 so a fresh boot at idx 0 matches the new slowest.
    poll_button now accumulates N clicks per DOUBLE_CLICK_MS window and fi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
    [config.h, input.cpp, input.h, main.cpp, matter_app.cpp, matter_app.h]
2026-04-25 S3 M4: external-supply diagnostic + supervisor IC requirement
    External-5V boot failure investigation. XIAO S3 boots cleanly on USB
    but locks up the instant Matter's BLE+WiFi init runs on any external
    supply (Mini360, industrial 24→5V converter, even 3.3V direct to the
    3V3 pad). Forum thread 283702 nails the root cause: the XIAO's EN pin
    uses a weak pull-up + small cap that needs a clean USB-class voltage
    step. Slow-rising external supplies leave EN in an indeterminate region;
    some peripherals come up (motor / knob / LEDs work for ~5 s) but radio
    init silently wedges the CPU. No brownout, no panic — the chip is
    genuinely partial-reset.
    We confirmed this by: capping WiFi TX power, disabli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
    [main.cpp]
2026-04-25 S3: add supermini_m4 build for Teyleten ESP32-S3 + cleanup pass
    New target: Teyleten ESP32-S3 SuperMini (Amazon B0D47HBFDY). Same chip,
    same firmware behavior — only the GPIO numbers differ. pins.h gates the
    two boards behind BRUSHLESSLAMP_BOARD_TEYLETEN, set at project COMPILE_OPTIONS
    so common code (motor.cpp) sees the same map as main.
    Wins on the SuperMini layout:
    - LED_CW (43→7) and nSLEEP (44→10) move OFF the UART0 strap pins, so
    the boot-time UART flicker on LED_CW disappears and we no longer need
    to fight the external pull-up on nSLEEP at POR.
    - New PIN_DRV_EN (GPIO 8) gives software control of the DRV8313's EN line
    for the first time; XIAO had it jumpered to 3V3 on the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
    [partitions.csv]
2026-04-28 S3 M4: re-add deferred matter_app_init for graceful external-power degradation
    Brings back the 5 s deferral of matter_app_init() into a separate task on
    CORE_OTHERS. Previously removed in the cleanup pass as 'experiment that
    didn't help'; on USB it's true that PHY cal happens regardless. But on a
    marginal external supply the lamp now stays usable for the first 5 s —
    motor / knob / LEDs run normally — even if Matter's BLE+WiFi PHY init
    later wedges the chip. Local control is preserved instead of failing
    hard at boot. Matters even more without a supervisor IC on the rail.
    Mirrored to both m4-matter (XIAO) and supermini_m4 (Teyleten).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
    [main.cpp]
2026-04-28 S3: production-config docs + clean up stale comments
    Top-level README: drop the C6 hardware tables / wiring / milestones from
    the main flow; restructure as a short product summary with a strong pointer
    to s3/README.md, then move all C6 content under a single "Historical (C6,
    frozen for rollback)" header. The earlier blockquote-only S3 redirect was
    easy to miss; new layout makes XIAO S3 + M4 the unambiguous current path.
    s3/README.md: replace the supervisor-IC-required BOM rows with the
    cap+diode parts that are the actual intended hardware mitigation. Wiring
    diagram updates to show SS14 + 470 µF in the production rail. New § 7.1
    "Known limitation: external 5 V boot fails" catalogues the EN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
    [main.cpp, pins.h]
2026-04-28 S3 M4: external-power diagnostic instrumentation + IDF 5.5.4 upgrade
    Diagnostic for the reproducible external-power hard-hang at uptime ~9.65s.
    USB power from a laptop works (chip boots, completes Matter init, can
    then survive USB disconnect). USB power from a power brick or any
    external 5V supply hangs at the same point — narrowing the root cause
    to USB-host-enumeration-dependent radio init, not supply quality.
    Stack upgrades (none of these moved the wedge — verified ±50ms identical
    signature pre/post):
    - ESP-IDF 5.4.4 → 5.5.4 (NimBLE host fix, BLE coex improvements per
    release notes, GitHub issues #12714 and #13058 marked resolved)
    - esp-matter release/v1.5 re-cloned, connectedho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
    [main.cpp, matter_app.cpp, motor.cpp]
2026-04-28 S3: BBPLL consumer pin + bare-NimBLE isolation test
    m4-matter:
    - main.cpp: rtc_clk_bbpll_add_consumer() at boot keeps BBPLL alive against
    the USJ connection-monitor's auto-removal when no USB host SOF packets
    arrive. Diagnostic-targeted fix that did NOT resolve the external-power
    wedge (still wedges at the same matter-init-relative time). Kept in
    place because it's harmless and sound; the issue is just deeper than
    BBPLL clock state.
    s3/test_ble/: new isolated test build.
    - Pure ESP-IDF + NimBLE host. No Matter, no esp-matter, no
    arduino-as-component, no SimpleFOC, no WiFi.
    - Same NVS-persisted boot_dbg + GPIO 21 heartbeat as m4-matter so we can
    read prev_ckpt forensically afte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
    [main.c, main.cpp]
2026-04-28 S3: bisection chain — wedge is in esp-matter, not below
    Two new test builds isolating the external-power wedge layer-by-layer.
    Both are confirmed working on external 5V (no USB host) end-to-end.
    s3/test_ble/ (already committed previously, now augmented):
    - Pure ESP-IDF + NimBLE + WiFi station, no arduino-as-component, no Matter.
    - Result on external power: prev_ckpt=7 (full BLE init complete).
    - Conclusion: IDF / NimBLE / BLE controller / WiFi PHY are fine.
    s3/test_ble_arduino/ (new):
    - test_ble + arduino-as-component + initArduino() +
    ARDUINO_USB_CDC_ON_BOOT=1 + ARDUINO_USB_MODE=1.
    - All the layers m4-matter has EXCEPT esp-matter / CHIP.
    - Result on external power: prev_ckpt=7. Works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
2026-04-29 S3 M4: external-power fix + commission verified + production polish
    External 5 V boot now works on the production wiring (Mean Well → Mini360 →
    XIAO 5V). Apple Home and Google Home commissioning verified end-to-end on
    real hardware with the same supply.
    Root-cause fix:
    - CONFIG_ENABLE_CHIP_SHELL=n. The esp-matter Kconfig default spawned a
    ChipShellTask running linenoise() → usb_serial_jtag_read(), which returns
    -1 immediately without yielding when no USB host is attached. The task
    pegged core 0 at high priority, IDLE never ran, the Task WDT panicked at
    5 s. Looked exactly like a hardware lockup until a TWDT user-ISR hook
    captured cpu0='console' to RTC slow memory.
    - CONFIG_E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
    [input.cpp, leds.h, main.cpp, matter_app.cpp, motor.cpp]
2026-05-16 S3 M4: Matter reliability hardening + motor init safety + comment cleanup
    sdkconfig (s3/m4-matter/sdkconfig.defaults):
    - ESP_TASK_WDT_PANIC=y (clean reboot if any task starves IDLE)
    - LWIP_TCPIP_TASK_STACK_SIZE=4096 (mDNS + CASE burst post-commission)
    - ESP_WIFI_TX_BA_WIN=16 (symmetric AMPDU; RX was already 16)
    - LWIP_DHCP_DOES_ARP_CHECK=n (skip ~1 s probe on Wi-Fi reconnect)
    - CHIP_IM_MAX_NUM_READ_HANDLER=6, MAX_CHIP_SUBSCRIPTIONS=6 (Apple + Google + HA concurrent)
    - HEAP_POISONING_LIGHT=y (early detect; names offender)
    - LWIP_NUM_NETIF_CLIENT_DATA=4 (mDNS metadata slots)
    s3/common/motor.cpp:
    - Hoist esp_task_wdt_delete(IDLE for CORE_MOTOR) above initFOC; a stuck
    rotor / supply sag can p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
    [input.cpp, leds.cpp, main.cpp, matter_app.cpp, motor.cpp]
2026-05-21 S3 M4: physical-direction inversions + commissioning silent-fail doc
    Motor: swap PIN_PWM_A ↔ PIN_PWM_B on both XIAO and Teyleten boards
    (electrically equivalent to swapping two motor wires); SimpleFOC's initFOC
    re-detects sensor_direction at boot, so the closed loop stays internally
    consistent and the rotor now turns the opposite physical direction for the
    same Matter level / knob target.
    Knob: invert ++/-- in onKnobEdge so the rotary encoder feels right with the
    inverted motor. Single ISR change; affects motor-nudge and LED-brightness
    paths uniformly.
    LEDs: swap PIN_LED_WW ↔ PIN_LED_CW so the warm/cool mapping in Google Home /
    Apple Home matches the physical LED channels. No math chan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
    [input.cpp, motor.cpp, pins.h]
2026-05-21 S3 M4: first-boot lead-screw homing + persistent sensor_direction cache
    Two related changes to make the lead-screw lamp self-calibrate to its
    mechanical off-stop on first install:
    1. First-boot homing (NVS gated, factory-reset triggered):
    - foc_cal:homed flag; absence triggers a closed-loop velocity ramp
    toward -10 rad/s until the existing stall detector trips against the
    mechanical off-stop. Then the flag is written and esp_restart() fires.
    - The reboot is intentional: re-initialising the FOC + encoder in-process
    at the wedged off-stop position doesn't recover (alignment can't sweep
    with rotor pinned, and the saturated-Uq stall corrupts internal state).
    A har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
    [motor.cpp]
2026-05-21 S3 M4: Matter commissioning reliability + post-homing runaway fix + code-quality pass
    **Commissioning reliability**
    - Add kFailSafeTimerExpired handler that re-opens the basic commissioning window
    (BLE + DNS-SD, 300 s) when the fabric table is empty. PASE-establishes-then-
    AddNOC-times-out is a common intermittent failure under CDC backpressure /
    stack pressure; without this, BLE advertising does not auto-restart and the
    controller's retry has nothing to discover until the next user-initiated
    retry. Matches "first attempt fails, retry works" symptom.
    - Add kCHIPoBLEConnectionEstablished / Closed logging so the next intermittent
    failure has named timestamps instead of silent gaps.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
    [config.h, input.cpp, leds.cpp, leds.h, main.cpp, matter_app.cpp, matter_app.h, motor.cpp]
2026-05-21 S3 reorg phase 1: archive milestone + diagnostic stages
    Move dev-history and bring-up scratchpads out of s3/ root so the shipping
    firmware (m4-matter/) stands alone. Pure file moves via git mv — no code or
    build-path changes for the production target.
    s3/
    ├── m4-matter/ (unchanged — ships)
    ├── common/ (unchanged)
    ├── components/ (unchanged)
    └── archive/ (new)
    ├── milestones/
    │ ├── m1-motor/, m2-knob/, m3-leds/, supermini_m4/
    └── diagnostic/
    ├── test/, test_ble/, test_ble_arduino/, test_ble_arduino_async/
    Add s3/archive/README.md explaining what each subdir is and that none of them
    ship.
    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
    [partitions.csv]
2026-05-21 S3 reorg phase 2: rename m4-matter → firmware + restore baseline motor enable() path
    **Reorg:**
    - s3/m4-matter/ → s3/firmware/ (the "m4" prefix was a milestone-tag dev artifact,
    not a product name; the production app is just "firmware").
    - CMake project(brushlesslamp_m4_matter) → project(brushlesslamp). Built binary
    is now brushlesslamp.bin instead of brushlesslamp_m4_matter.bin.
    - s3/README.md and top-level README.md updated to reflect the new layout
    (production firmware/ + shared common/ + vendored components/ + archive/).
    **Motor revert (regression fix):**
    - Earlier today I added a "reset commanded_vel + last_ramp_us + motion_started_ms
    + stuck_since_ms on every motor.enabl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
    [partitions.csv]
2026-05-21 S3 firmware: persistent position + Matter commissioning reliability + gentler homing
    **Position persistence across plug/unplug** (the lead-screw motor can't be
    moved by hand, so the rotor's physical position survives power cycles — but
    the incremental encoder resets to 0. Persisting the user-coord position to
    NVS lets us reconstruct it on next boot).
    - New foc_cal:pos NVS blob (float). Saved on every idle-disable transition
    with > 0.1 rad movement since last save (debounced for flash wear).
    - On boot, load saved position; set s_home_offset = shaft_angle - saved so
    user_angle = saved_value immediately. s_target_angle initialised to the
    saved value so the motor holds position; s_sync_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
    [config.h, matter_app.cpp, motor.cpp]
2026-05-22 S3 firmware: smoother LED fade + dead-code purge + concurrency + docs
    **LED fade (Option A — slower + wider window)**
    - LED_FADE_ANGLE_RAD 1.0 → 3.0 rad. At MOTION_VELOCITY=15 rad/s the motor
    crosses the fade window in ~200 ms instead of ~67 ms — the fader can
    actually do its smoothing inside the motor's travel window now.
    - LED_FADE_STEP 3 → 1. Full 0..255 sweep ≈ 2.55 s (was 0.85 s); typical
    fade to gamma(200)≈153 is ~1.5 s vs the previous ~500 ms snap.
    - Fixes the "weird, sometimes too fast" regression where the LED brightness
    was tracking shaft_angle in real time but the fader's step rate was non-
    monotone in motor speed — fast motor commands made LEDs snap then t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
    [config.h, leds.cpp, leds.h, matter_app.cpp, matter_app.h, motor.cpp, motor.h]
2026-05-22 S3 firmware: fix Google Home CT slider — declare ColorTempPhysical Min/Max
    Symptom: Google Home's color-temperature slider showed only the two
    endpoint presets (Candlelight / Blue sky) with no smooth interpolation
    between them. Pre-selected presets (Cool, Cool White, Warm White, etc.)
    worked because they ship discrete mireds values.
    Root cause: esp-matter's color_temperature_light::config_t leaves
    ColorTempPhysicalMinMireds / MaxMireds at their constructor defaults of
    1 / 0xFEFF (65279). Google Home reads those alongside ColorCapabilities
    bit 4 and the FeatureMap CT bit to render the slider; with the (1,
    65279) "uninitialized" sentinels it falls back to the 2-stop UI.
    Fix in matter_app.c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
    [config.h, matter_app.cpp]
2026-05-23 S3 firmware: persist color temperature to NVS + warmer default
    Mirror the LED brightness persistence pattern for the color temperature so
    the lamp resumes the last chosen tint across reboots. Boot-time sync pushes
    the restored value into Matter so commissioned controllers see the correct
    state without user interaction. Default lowered to 370 mireds (≈2700 K,
    Google Home "Soft White"), the 2nd-warmest of Google's six presets.
    Also refresh the README's gesture table — it had drifted from input.cpp
    (single/double/triple-click mappings were swapped) — and document the new
    `leds:ct` NVS key alongside `leds:maxduty`.
    [config.h, leds.cpp, leds.h, matter_app.cpp]
2026-05-23 S3 firmware: 3-mode knob cycle — motor / brightness / color temperature
    Double-click now cycles the knob target through three modes instead of two.
    CT mode nudges color temperature by KNOB_CT_STEP_MIREDS per detent and pushes
    the new mireds back to ColorControl::ColorTemperatureMireds so Google Home /
    Apple Home reflect the change in real time. 1/2/3 LED blinks indicate the
    entered mode; triple-click (speed preset) remains unchanged.
2026-05-23 S3 firmware: smooth ColorTemperatureMireds slider drags in Google Home
    Google Home sends MoveToColorTemperature commands with TransitionTime=0 as
    the user drags the CT slider; the cluster snaps ColorTemperatureMireds to
    each new value with no interpolation, so the existing per-channel WW/CW
    fader saw step-jumps in its targets — visible as abrupt color changes.
    Split the CT into target/current: controllers and the knob set the target
    instantly, the fader interpolates the current toward it at
    CT_FADE_STEP_MIREDS per 10 ms tick (~600 ms full warm↔cool sweep). WW/CW
    are computed from the smoothly-interpolated current and still go through
    the per-channel duty fader, so the visible color glid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
    [config.h, leds.cpp]
2026-05-30 S3 firmware: add m1/m2/m3/m4 modules and esp-idf app_main scaffold
    Adds the ESP32-S3 development tree (s3/m1-motor, m2-knob, m3-leds, m4-matter,
    test_ble_arduino) and the native ESP-IDF + esp-matter entry point. Extends
    .gitignore to cover all of .claude/ and macOS Icon files.
2026-06-08 Add custom all-in-one PCB design package
    WROOM-1-N8R8 + DRV8313 board to replace the XIAO + SimpleFOC Mini stack:
    architecture/pinmap, schematic blocks, BOMs, Fusion Electronics workflow,
    component libraries (.lbr), the generated schematic, and PCBWay assembly docs.
    [03-bom-mainboard.csv, 03-bom-sensor.csv, 06-bom-assembly.csv, BrushlessLamp.sch, ESP32-S3-WROOM-1-N8R8.STEP, PCBWay-BOM.xlsx]
2026-06-09 S3 firmware: review fixes — real current limit, stall recovery, Matter state seeding
    - estimated_current torque mode: voltage mode in SimpleFOC 2.4.0 silently
    ignores current_limit/phase_resistance; a stall could push 3.6 A into the
    DRV8313's 3 A OCP latch. Velocity PID gains rescaled by 1/R (0.04/4/30 A-units).
    - runtime stall detection: accept the jammed position as target, pulse nSLEEP
    to clear latched faults, sync the level back to Matter on settle.
    - DRV8313 sleeps via nSLEEP during idle-disable (~25-100 mW saved, faults
    auto-clear); 1 ms tWAKE honored on wake.
    - loopFOC/move run while disabled so back-driven motion stays visible;
    position-loop deadband inside POS_AT_REST_EP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
    [config.h, input.cpp, input.h, leds.cpp, main.cpp, matter_app.cpp, motor.cpp, motor.h]
2026-06-09 PCB: fix reverse-protection FET orientation, Vgs clamp, fuse land + BOM errors
    - Q1 P-FET was wired source-to-input: body diode conducted on reversed 24 V
    and the channel blocked nothing. Now drain=input/source=load; gate zener
    clamps G-S and drops 15 V -> 10 V (AO3401A Vgs abs-max is +/-12 V).
    - F1: 0466002.NR is a fast NANO2 that didn't fit the 1206 land; now
    0454002.MR slow-blow on a proper NANO2 land (125 V, survives bulk-cap inrush).
    - TVS SMBJ30A -> SMBJ28A with honest clamp-margin rationale (full-surge VC
    exceeds the buck's 40 V abs-max; accepted residual risk documented).
    - C_BOOT mainboard BOM row said 0.1 uF — the exact value the schematic
    forbids (GPIO0 download-mode s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
    [03-bom-mainboard.csv, 06-bom-assembly.csv, BrushlessLamp.sch, PCBWay-BOM.xlsx]
2026-06-09 Docs + repo hygiene: sync READMEs with code, drop stale trees and cached junk
    - s3/README: 77 rotations (was 100), WW/CW and PWM A/B pin tables match
    pins.h again, stall timing ~0.6 s, archive paths, sdkconfig 7.2 mirror
    rebuilt from defaults (incl. SPI_FLASH_AUTO_SUSPEND and the DHCP
    choice-member fix), spd_idx 0..2.
    - MORNING_STATUS / PHASE15 marked historical (item 4 of the former
    recommended the CHIP_SHELL setting later proven to TWDT-panic production).
    - remove broken pre-archive re-adds (s3/m1-motor, m2-knob, m3-leds,
    m4-matter, test_ble_arduino — newer copies live in s3/archive/), dead
    esp-idf/main/app_main.cpp, and 1099 committed clangd index files
    (s3/.gitignore now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
    [main.cpp]
2026-06-09 S3 firmware: revert torque mode to voltage — estimated_current audibly louder
    Bench listening confirmed estimated_current makes the motor louder: its
    back-EMF feed-forward (~55 mV per rad/s at KV=100) is added to Uq raw —
    no filter, no slew limit, stepping at the 1 kHz motion rate — and as
    positive velocity feedback it cancels the motor's EM damping (underdamped
    hunting at standstill/reversals). Matches SimpleFOC forum thread 8111 and
    the docs' recommendation of voltage mode for low-speed gimbals.
    Voltage mode + original PID (0.2 / 20 / 150 V-units) restored. Stall
    current is bounded by the runtime stall handler (accept + nSLEEP fault
    clear in ~0.55 s) instead of current_limit, which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
    [config.h, motor.cpp]
2026-06-10 S3 firmware: wake the parked motor on commands only, never on back-drive
    Homing captures logical 0 at the wedged-into-the-stop position, so the lead
    screw holds elastic preload there. With the refactor's wake-on-backdrive
    (shaft drifting >0.3 rad from target re-engaged the motor) plus the free
    Hi-Z idle, the preload unwound the rotor upward past the threshold and the
    motor chased it back down into the stop in an endless re-wedge cycle —
    "the 0 keeps going". The old loop never had this because it skipped
    loopFOC() while parked and was blind to physical motion.
    While parked, the wake check now compares the target against a snapshot of
    the parked position, restoring the old command-only wake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
    [motor.cpp]
2026-06-10 PCB docs: fix assembler SMD count + DNP list, sync stale firmware refs
    Second design review (verified against the XIAO ESP32-S3 and SimpleFOC Mini
    reference schematics + part datasheets) found no netlist/wiring bugs — only
    doc errors:
    - 06-pcbway-assembly: SMD part count 61 -> 58 (didn't reconcile: 65 placed
    = 58 SMT + 7 THT); DNP list corrected in three places (was missing
    R_AZ_A/B/C; referenced C_DP/C_DM which aren't on this board).
    - 01/README/05: LEDC 8-bit -> 10-bit; "1024 CPR" -> "1024 PPR (4096 CPR
    quadrature)" to match firmware (LED_PWM_RESOLUTION=10, ENCODER_PPR=1024).
2026-06-10 S3 firmware: add BRUSHLESSLAMP_BOARD_CUSTOM pin map for the all-in-one PCB
    Third board branch in pins.h for the custom WROOM-1-N8R8 board (design
    package in PCB/), selected with -DBRUSHLESSLAMP_BOARD_CUSTOM=1. GPIO map
    mirrors PCB/01-architecture-and-pinmap.md §4 net-for-net (verified by the
    PCB review), including the PWM_A->IN2 / PWM_B->IN1 swap and the new (wired
    but firmware-unused) nFAULT/Z-index pins. main.cpp's XIAO user-LED init is
    now scoped to the XIAO target so the custom build doesn't reference the
    undefined PIN_XIAO_USER_LED (provable no-op for XIAO/Teyleten — binary
    unchanged, not reflashed).
    Compile-checked three ways: host g++ -std=gnu++2b syntax-check of all three
    board c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
    [main.cpp, pins.h]
2026-06-16 S3 firmware: knob-hold re-home gesture + fix turn-off restart loop
    The "won't turn off, keeps restarting" loop and the need for a re-home are the
    same root cause: logical 0 had drifted from the physical off-stop, so a
    turn-off drove the motor into a hard wedge (~3.6 A in voltage mode → brownout
    reset → reboot restores the on-height → repeat), or it bottomed out at a high
    logical angle whose settle callback pushed OnOff=true back to Matter — a stall
    literally turning the lamp back on.
    - Runtime re-home: drive to the off-stop at a soft 1 V cap (~0.2 A, can't
    brownout) and set that position as logical 0. Re-zeros s_home_offset without
    a reboot (FOC stays calibrated). motor_request_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
    [config.h, input.cpp, input.h, main.cpp, matter_app.cpp, matter_app.h, motor.cpp, motor.h]
2026-06-16 S3 docs/comments: resync to code — LED 10-bit, triple-click speed save, WDT + factory-reset paths
    Review pass found no logic bugs; only comments/docs had drifted from the code:
    - leds.cpp: stale "11-bit / 0..2047" comments → actual 10-bit / 0..1023
    - config.h, motor.cpp, matter_app.cpp: reword change-log style comments to describe current behavior
    - README: LED gate 8-bit→10-bit; spd_idx saved by triple-click (not double); IDLE-WDT now via CONFIG_ESP_TASK_WDT_CHECK_IDLE_TASK_CPU1=n (not esp_task_wdt_delete); button factory reset uses full nvs_flash_erase
    [config.h, leds.cpp, matter_app.cpp, motor.cpp]
2026-06-16 S3 Matter: advertise Dimmable + On/Off subset device types on the light endpoint
    DeviceTypeList now lists Color Temperature Light (0x010C) + Dimmable Light
    (0x0101) + On/Off Light (0x0100). CT Light is a superset of both, so no new
    clusters/attributes are added — purely Descriptor metadata, zero behavior
    change. Aim: give controllers that gate features (e.g. Google gentle wake) a
    plainer light device type to match. Controllers cache DeviceTypeList at
    commissioning, so re-pair to pick it up.
2026-06-17 S3 docs: scrub per-device commissioning secrets from mfg-tool example
    Replace the pinned --passcode/--discriminator/--serial-num real values with a
    placeholder + a note never to commit per-device commissioning secrets. Prep for
    making the repo public. (The values remain in history commit 27360be — see
    follow-up note; regenerate this dev lamp's identity to invalidate them.)
2026-06-17 S3: self-hosted signed OTA over GitHub Releases
    - ota.cpp/.h: low-prio task polls a JSON manifest (version+url) on GitHub
    Releases, and when version > OTA_FW_VERSION downloads via esp_https_ota
    (TLS via Mozilla cert bundle), then reboots into it once the lamp is idle.
    - Check cadence: ~1 min after every boot, then every 5 days.
    - Signed images (NO hardware Secure Boot / no eFuse): SECURE_SIGNED_APPS_NO_SECURE_BOOT
    + SECURE_SIGNED_ON_UPDATE_NO_SECURE_BOOT (RSA-3072). Device verifies the OTA
    image signature before applying — a spoofed URL can't push unsigned firmware.
    Signing key is gitignored (ota_signing_key.pem, the OTA root of trust).
    - CONFIG_DEVICE_SOFTWARE_VERSION_NUMBER tra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
    [config.h, main.cpp, ota.cpp, ota.h]
2026-06-17 S3: release 0.15.5 — boot banner prints firmware version
    - main.cpp prints "[boot] firmware v<ver>" (esp_app_get_description) so the
    running version is visible — confirms OTA-applied builds.
    - Version bumped to 0.15.5/155 across CMakeLists (PROJECT_VER[_NUMBER]),
    config.h (OTA_FW_VERSION), sdkconfig (DEVICE_SOFTWARE_VERSION_NUMBER).
    - Published as GitHub Release fw-0.15.5 (signed bin + manifest) for OTA.
2026-06-17 S3 OTA: follow GitHub's release redirect + size the HTTP buffers for it
    GitHub Releases assets 302-redirect to a ~700-char presigned CDN URL that
    esp_http_client/esp_https_ota don't auto-follow, and which overflowed the
    default 512 B header/request buffers ("HTTP_CLIENT: Out of buffer" -> status
    302). Fix: resolve_url() does the redirect hop itself (HEAD -> Location), both
    the manifest fetch and the image download use the final presigned URL, and all
    three requests set buffer_size/buffer_size_tx = 4096/2048 to hold it.
    Verified end-to-end over WiFi (no USB): device on 0.15.8 fetched the 0.15.9
    manifest, downloaded + RSA-verified the signed image, swapped to ota_1, and
    rebooted into 0.15.9.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
    [config.h, ota.cpp]
2026-06-17 S3: add release.sh — one-command signed OTA release
    Bumps the three version locations (CMakeLists PROJECT_VER[_NUMBER], config.h
    OTA_FW_VERSION, sdkconfig DEVICE_SOFTWARE_VERSION_NUMBER), builds the signed
    image in the no-space shadow tree, publishes a GitHub Release with
    brushlesslamp.bin + manifest.json, then commits + pushes the bump. Usage:
    ./release.sh <semver> <int>. Codifies the manual release flow used through 0.15.9.
2026-06-17 S3 docs: document the self-hosted signed OTA system (§11)
    - New § 11: how the OTA poller works (boot + 5-day check, manifest, redirect
    resolution, signed-image verify, idle-gated reboot), the signing setup + key
    backup, and the release.sh flow.
    - Fix stale § 7.2 note: updates use self-hosted esp_https_ota, not the Matter
    OTA requestor (which stays enabled only for the partition/app-update infra).
    - Add ota.cpp to the task layout + module map.
2026-06-17 S3 Matter: advertise only Color Temperature Light (drop subset device types)
    Listing Dimmable (0x0101) + On/Off (0x0100) alongside Color Temperature Light
    (0x010C) on one endpoint made Google Home intermittently resolve the lamp as a
    plain on/off device — no brightness/CT slider, "something went wrong". The
    subset types gave no confirmed benefit (gentle wake is a Google-side limit), so
    revert to a single device type.
    [matter_app.cpp]
2026-06-17 S3 Matter: WiFi self-heal watchdog (reboot on wedged reconnect)
    CHIP retries WiFi association every 100 ms but can wedge after AP loss
    (esp_wifi_connect → ESP_ERR_WIFI_CONN, "Failed to get configured network
    0x0500300F" — a known, upstream-unfixed esp-matter issue). A full reboot
    reinitializes the WiFi stack and clears it. net_watchdog_task polls
    IsWiFiStationConnected every 30 s; if commissioned + disconnected for 10 min it
    reboots once the lamp is idle (so it never interrupts local knob/motor use,
    which works offline), or unconditionally after 30 min for always-on lamps.
    Position restores from NVS, so a recovery reboot is cheap.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
    [config.h, matter_app.cpp]
2026-06-17 S3 Matter: advertise full Google CT range so all presets stick (incl. Candlelight)
    The warmest preset (Candlelight, ~1800 K) sat beyond our advertised max (454
    mireds / 2200 K): the cluster clamped it, so the value reported back didn't match
    what Google requested and the preset showed selected-then-deselected. Widen the
    ADVERTISED ColorTempPhysicalMin/Max to 111/588 mireds (~9000 K / ~1700 K) so
    Google/Apple's full preset set is accepted. The LED blend stays calibrated to the
    real CW/WW LEDs ([COLORTEMP_MIN, COLORTEMP_MAX] = 153/454) so everyday presets
    keep their true color; values past the physical ends render as full cool/warm.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
    [config.h, leds.cpp, matter_app.cpp]
2026-06-17 S3 OTA: reboot only when the motor is fully parked (fix zero corruption)
    Updating with the lamp on corrupted the homing zero: Matter flips OnOff=false
    instantly, but the OTA rebooted ~0.5 s later while the motor was still descending
    to the bottom — mid-travel, before the resting position was persisted. The next
    boot restored a stale saved position, so logical 0 no longer matched the physical
    off-stop and the motor drove toward a wrong target.
    Add motor_is_idle() (true only when disabled + at rest + position saved) and gate
    the OTA reboot on it (off AND parked), so an update can never interrupt mid-motion
    regardless of lamp state. Also set the idle flag around runtime re-homing.
    Co-Author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
    [motor.cpp, motor.h, ota.cpp]
2026-06-17 S3 OTA: gate reboot on physical core-down + motor-parked, not Matter OnOff
    The 1.0.5 gate waited on matter_get_on_off(), but Matter OnOff can read "off"
    while the core is still physically raised (state/position mismatch), so the OTA
    could still reboot with the lamp open and corrupt the saved zero. Gate instead on
    the real shaft angle (core below OTA_REBOOT_MAX_ANGLE_RAD = LED off) AND
    motor_is_idle() — purely physical, so a reboot only ever happens with the core
    down and the motor stopped.
    [config.h, ota.cpp]
2026-06-17 S3: reboot only for OTA install — remove WiFi watchdog; robustness review
    The only esp_restart() during normal operation is now the OTA install, gated on
    core-down + motor-parked. Removes the net_watchdog_task, which rebooted on WiFi
    loss (off + WiFi-down) — that fires during normal use on a flaky AP and was the
    likely "reboots when the LED turns off" regression; it also violated the
    reboot-only-for-OTA rule. CHIP's own 100 ms reconnect handles association.
    Also: set s_idle false during first-boot homing (and true at the parked boot
    baseline) so the OTA gate can't fire mid-homing; drop the now-unused matter_app.h
    include in ota.cpp; sync docs (CT advertised range 111-588, NVS clamp boun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
    [config.h, matter_app.cpp, motor.cpp, ota.cpp]
2026-06-18 S3 LEDs: extend warm anchor to 1700 K to match Google Home Candlelight
    COLORTEMP_MAX 454 -> 588 mireds so the LED blend reaches full warm-white at
    the warmest advertised preset; Candlelight now renders as warm as commanded
    instead of clamping to a cooler 2200 K blend. Cold end (COLORTEMP_MIN=153)
    unchanged, so the range is intentionally asymmetric.
2026-06-18 S3 LEDs: restore warm anchor to 2200 K (COLORTEMP_MAX 588 -> 454)
    A wider span dilutes warm presets with cool-white instead of warming them;
    the WW emitter caps at ~2200 K regardless, so 454 keeps everyday warm
    presets saturated to full warm-white. Candlelight still renders full WW.
2026-06-21 PCB: verify components + fully code BOM after deep review
    Datasheet-grounded review of the custom all-in-one S3 board confirmed the
    schematic, footprints, and firmware pin map are correct and faithfully
    replicate the XIAO + SimpleFOC Mini rig — no net/pad/value/footprint
    changes needed. All fixes are BOM/doc only:
    - D_Q1: C2687029 was a Fuzetec PTC fuse, not a BZT52C10 zener -> C216719
    - U_MCU: C2913202 is the N16R8 (16MB); use genuine N8R8 -> C2913201
    - C_IN2: MPN typo CL31B475KCHNNNE -> CL31B475KBHNNNE (50V) -> C51205
    - C_V3P3: uncataloged X5R MPN -> CL10B474KO8NNNC (X7R 16V) -> C105526
    - Fill all remaining LCSC codes (fuse, inductor, TVS, ESD, passives,
    connectors); J_SENSOR ships as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
    [03-bom-mainboard.csv, 06-bom-assembly.csv]
2026-07-13 PCB: rev 4.3 — fab-ready rework after PCBWay manufacturability review
    Board redesigned to 55x55mm and fully rerouted (by hand in Fusion) after
    order T-1P9W1088173A was rejected. Verified: 100% routed, zero shorts, zero
    wire-through-pad, sch/brd consistency PASS, all placements clear of housings
    and can bases.
    Footprints: CAP_V rebuilt on CAPAE830X1050N (8.3mm can), TACT rebuilt from
    the XKB TS-1187A datasheet with pairwise-bridged pads (original column wiring
    would have shorted EN/BOOT to GND), JST-XH and KF350 lands from vendor
    drawings, USB-C shell legs converted to plated slots (slot-isle pads +
    milling outline + 9-hit overlapping drill gangs that survive Fusion CAM;
    inject_slots.py ca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
    [B2B-XH-A--3DModel-STEP-56544.STEP, B3B-XH-A--3DModel-STEP-56544.STEP, BrushlessLamp.brd, BrushlessLampRoutes.brd, BrushlessLampRoutes.sch, DRV8313PWPR.STEP, KF350-2p.step, KF350-3p.step]
2026-07-23 S3: custom-PCB board option, status LED, fleet-safe release guard
    - BRUSHLESSLAMP_BOARD CMake cache option (xiao|teyleten|custom) selects the
    pins.h branch; defines scoped to common+main so a board switch never
    rebuilds the Matter stack. Verified on fabbed rev 4.3 hardware.
    - status_led.cpp (custom PCB only): GPIO21 LED renders fault 5 Hz (init
    failure or live DRV8313 nFAULT), boot/motor solid, pairing 1 Hz,
    WiFi-down 2.5 Hz, idle off. New motor_get_fault() +
    matter_is_commissioned()/matter_is_wifi_up() feed it.
    - release.sh aborts on a non-xiao configured shadow build dir — the OTA
    fleet is XIAO hardware with a different pin map.
    - Pin CONFIG_ENABLE_PERSIST_SUBSCRIPTIONS=y so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
    [main.cpp, matter_app.cpp, matter_app.h, motor.cpp, motor.h, pins.h, status_led.cpp, status_led.h]
2026-07-23 S3: mDNS re-announce self-heal while commissioned but unsubscribed
    Google hubs (current firmware) fail to subscribe to newly commissioned
    devices until the hub itself reboots. While commissioned + WiFi-up with
    zero active subscriptions, re-broadcast the operational DNS-SD records
    every 2 min so a wedged controller can rediscover the device; the printf
    doubles as a live has-subscription probe on the serial log. Silent once
    any controller subscribes.
    [matter_app.cpp]
2026-07-23 S3: no-reboot commissioning + review bugfixes (fw-1.2.4, OTA 10204)
    Failsafe now reopens the commissioning window in place instead of
    rebooting — IDF 5.5.4 no longer wedges NimBLE after a partial commission,
    so the reboot is unnecessary and only disrupts the controller's
    post-commission work. Reboots solely as a fallback if reopening fails.
    Review fixes:
    - motor: a runtime re-home that times out no longer persists a wrong
    logical zero — gated on reaching the off-stop; the caller keeps the
    real park reference instead of snapping to a false 0 on timeout.
    - motor: boot idle sleeps the DRV8313 (nSLEEP low = free shaft) instead
    of leaving disable()'s shorted-winding brake, matching run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
    [config.h, leds.cpp, matter_app.cpp, motor.cpp, ota.cpp]
2026-07-23 S3: custom-PCB-only OTA with board guard; freeze XIAO fleet at 1.2.3
    The OTA fleet is now the custom PCB. release.sh builds the custom board
    and publishes manifest-custom.json + brushlesslamp-custom.bin; no release
    ships manifest.json anymore, so legacy XIAO lamps (no board check,
    polling that name) 404 forever and stay frozen at 1.2.3 by design.
    Firmware guard: the manifest carries a "board" field and the device
    refuses any manifest that doesn't match its compiled board — a published
    image for another pin map can never be staged. Failed manifest fetches
    or downloads retry hourly instead of waiting out the 5-day interval.
    Verified on hardware: custom PCB fetched the live legacy manifest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
    [config.h, ota.cpp]
2026-08-27 S3: reverse custom-board motion frame (crossed ENC_A/B) + calibration migration
    The custom-hardware build is mechanically mirrored vs the XIAO rig: homing
    found the wrong end, so Matter level (and knob +) drove the lamp down.
    Crossing ENC_A/B flips the logical frame — positive angle = lamp up — which
    corrects Matter, knob, off-state, LED fade, and homing together.
    foc_cal gains a frame-version key: on first boot after the flip the cached
    sensor_direction is negated in place (deterministic; avoids the unreliable
    direction sweep at the off-stop) and homed/pos are wiped so first-boot
    homing re-runs toward the new frame's bottom stop. XIAO/Teyleten frames
    are unchanged (version 1 = no-op).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
    [motor.cpp, pins.h]
2026-08-27 S3: pull back the frame flip — restore original ENC_A/B on custom
    fw-2.1.1's crossed-encoder frame did not fix the inverted control on the
    installed lamp, so restore the original encoder order. The frame-migration
    machinery stays with FOC_FRAME_VERSION back at 1: lamps that ran 2.1.1
    (stored frame 2) migrate down — cached sensor_direction flips back and
    homing re-arms — while lamps that never updated see a no-op.
    [motor.cpp, pins.h]
2026-08-27 S3: frame version 2 — ENC A/B physically swapped at J_SENSOR
    The installed lamp's encoder A/B wires are crossed at the screw terminal
    (hardware direction fix); the pin map is unchanged. Bumping the frame
    version makes the one-time migration flip the cached sensor_direction and
    re-arm homing so the lamp recalibrates itself to the new wiring on the
    first boot after this update.
    [motor.cpp]
2026-08-27 S3: fix inverted motion via PWM phase order (the real frame anchor)
    The user-visible rotation frame is anchored by motor phase order, not
    encoder wiring: SimpleFOC's sensor_direction multiplies into the measured
    angle, so any encoder-sense change (firmware pin cross or physical A/B
    wire swap) is auto-normalized and cancels exactly — which is why the
    fw-2.1.1 encoder cross and the physical wire swap both changed nothing.
    Restore the natural DRV8313 IN1/IN2 order on the custom branch (undoing
    the XIAO-era A/B swap) to negate the frame for this build's mirrored
    mechanics, with frame-version 3 migration (flip cached sensor_direction,
    re-arm homing). Verified on the installed lamp: homing land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
    [motor.cpp, pins.h]
2026-08-28 S3: swap WW/CW LED pins for the as-built lamp; document as-built deviations
    The installed lamp's warm/cool strips are wired to the opposite gates
    than the schematic net names, so PIN_LED_WW/PIN_LED_CW swap (12/11).
    Open-loop LEDC — no state migration needed. README gains an as-built
    notes section (motion frame, crossed encoder wires, LED strip swap) and
    corrects the release/fleet description to custom-only OTA.
    [pins.h]
2026-08-31 S3: cap travel at 95% of previous max (ANGLE_MAX 77 -> 73.15 rotations)
    The lamp opened slightly past its comfortable top; 100% now lands where
    95% used to. Saved positions above the new max are already clamped on
    restore, so an updated lamp walks down to the new top on first wake.
2026-08-31 S3: scale the LED fade to the move instead of a fixed bottom sliver
    The fade spanned a fixed 3 rad — under 1% of the 73-rotation travel — so
    the lamp only dimmed in the last sliver before the stop. The ramp now
    spans LED_FADE_FRACTION (10%) of the move's nonzero endpoint: a rise
    fades in over the first 10% of its target, a descent fades out over the
    last 10% of the height it left. motor.cpp tracks that endpoint
    (s_fade_reference, exposed via motor_get_fade_reference) — the target
    while raising, the previous nonzero target while lowering to 0 — and a
    minimum window keeps very small moves from snapping on.
    [config.h, leds.cpp, motor.cpp, motor.h]
2026-08-31 S3: widen the LED fade window to 25% of the move
    10% was too abrupt in person.
2026-08-31 S3: raise all three speed presets (~45% faster)
    15/25/40 -> 22/34/48 rad/s, with the default cruise cap following
    preset 0. The top preset stays under VELOCITY_LIMIT (50) so SimpleFOC
    never clamps the setpoint, and under the 18 V Uq cap at that speed.
2026-08-31 S3: fix the Matter fade-out — reference the live position, speed the fader
    Lowering now takes the fade reference from the actual shaft position
    instead of the last commanded nonzero target. The knob fades correctly
    because each nudge re-sets a nonzero target, so the reference tracks the
    descent; a Matter off jumps straight to target 0, leaving the reference
    at a stale or low level and collapsing the fade window to nothing — the
    lamp stayed lit until it was essentially closed.
    LED_FADE_STEP 4 -> 12 so the fader (~1.5 s for a full dim) is no longer
    slower than a short descent, which left the light on past the stop.
    [config.h, motor.cpp]
2026-08-31 S3: hold a faint glow until the lamp seats
    Gamma plus 10-bit quantisation drove the duty to 0 while the shaft still
    had visible travel left, so a close finished in the dark. Floor the duty
    at LED_MIN_ON_DUTY while travelling and cut to true black only below
    LED_OFF_ANGLE_RAD, which sits above the position deadband so a parked
    lamp is never left glowing.
2026-09-03 S3: cap motor phase current in software; move LED PWM off 25 kHz
    Sporadic LED dips during moves on both knob and Matter point at 24 V rail
    sag from motor current: the strip is resistor-limited (~30 %/V) and a
    stalled or binding motor could pull 3.6 A phase (~4 A bus) at the 18 V Uq
    ceiling, past the PSU's 3.2 A rating.
    - CURRENT_LIMIT 2.0 A is now enforced in voltage mode: each FOC tick sets
    the Uq limit to I·R + back-EMF(ω) via updateVoltageLimit(), so the cap
    holds from standstill (~10 V) to cruise (~12.4 V at 43 rad/s). A limit,
    not a feed-forward, so estimated_current's back-EMF noise stays out.
    - LED PWM 25 → 30 kHz so strip and phase-current pulses cannot sit in a
    fixed ph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
    [config.h, motor.cpp]
2026-09-03 S3: lower the motor current cap to 1.0 A
    fw-2.2.3's 2 A cap reduced but did not remove the LED brightness dips during
    moves, and the lift still has plenty of torque headroom. Uq cap is now ~5 V at
    standstill, ~7.4 V at the fastest preset.
2026-09-03 S3: move LED PWM to 22.5 kHz, midway between the motor's spectral lines
    The motor's 24 V rail current has lines at 25 kHz (PWM carrier) ± n × 5 kHz
    (FOC update rate), i.e. every 5 kHz. An LED PWM on or near a line beats with
    it at a slow, visible rate through the shared rail: 25 kHz was on the carrier,
    30 kHz on a sideband, 20 kHz would be too. 22.5 kHz puts the nearest beat at
    2.5 kHz. Still inaudible, still 10-bit on the XTAL clock.
2026-09-03 S3: lower the motor current cap to 0.7 A
    LED dips during moves persist at 1 A; lift still has headroom. Uq cap is now
    ~3.5 V at standstill, ~5.9 V at the fastest preset.
2026-09-03 S3: restore the full 18 V motor drive (current cap 3.6 A)
    The 0.7 A cap made the LED flicker during moves worse, not better: the
    velocity loop saturates on friction spots and the resulting slow current
    swings show on the strip more than the higher steady current did. 3.6 A
    equals VOLTAGE_LIMIT / PHASE_RESISTANCE, so the per-tick cap now sits at
    the 18 V ceiling everywhere, matching the pre-2.2.3 drive. The cap code stays
    in place for future tuning. LED PWM stays at 22.5 kHz.
2026-09-03 S3: slide motor current in at move start; freeze the LED fade window mid-fade
    The remaining LED flash sits at the start of a descent: the motor's current
    turning on drops the shared 24 V rail ~0.2 V and the resistor-limited strip
    steps ~7 % in tens of ms. PID_OUTPUT_RAMP 150 → 25 V/s stretches that into a
    ~0.4 s slide the eye ignores, and lowers the breakaway spike.
    The fade reference was re-anchored on every target write, so a command landing
    while the shaft sat inside the fade window stepped the brightness: a knob
    detent past zero snapped to full, an Off mid-rise snapped to full then
    re-faded, an On mid-descent or a slider raise from a low level dipped.
    anchor_fade_reference() now re-an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
    [config.h, matter_app.cpp, motor.cpp]
2026-09-03 S3: revert the move-start ramp and fade-window freeze (back to 2.2.7 behavior)
    fw-2.2.8's PID_OUTPUT_RAMP 25 V/s, anchor_fade_reference() and the Matter
    transient-level skip read worse on the lamp than 2.2.7. This restores the
    150 V/s ramp, the per-write fade re-anchor and the direct CurrentLevel apply.
    This reverts commit 0357028b.
    [config.h, matter_app.cpp, motor.cpp]
